liyunlong-fred/motor-vibration-fault-detection/README.md

# 电机振动故障检测

一个以 **STM32 + MPU6050** 为采集端、以 **Python** 为分析与数据管理端的电机/风扇振动检测项目。

项目围绕低速小型直流风扇，建立从传感器采样、频谱分析、串口传输、数据质量检查，到后续**轻量模型**训练与**边缘部署**的完整技术链路。当前模型标签契约聚焦于三类可控工况：**正常、不平衡、安装固定处机械松动**。

项目的核心目标不是只输出一张频谱图，而是把“机械故障机理、嵌入式实时处理、PC 数据管线和可复现实验”连接成一套可以继续扩展的工程骨架。

## 项目亮点

- **端侧实时信号处理**：STM32 以 1 kHz 定时采样，使用 1024 点双缓冲窗口，在板上完成去均值、Hann 窗、CMSIS-DSP 实数 FFT、单边幅值谱和 TOP-5 峰值提取。
- **物理可解释的检测思路**：以转频 1×、2×/3× 谐波、频带能量和幅值变化作为分析线索，优先使用加速度频谱，而不是直接依赖难以解释的原始时域波形。
- **固件与 PC 端同口径对拍**：板上 FFT 和 Python 检查脚本共享采样率、窗口长度、轴向、加窗和峰值搜索范围，可用同一窗口核对 bin、频率和幅值。
- **从原始字节到数据集的完整链路**：固件通过 USART1 发送带窗口序号、采样点数和量程信息的原始数据帧，Python 端负责拆帧、落盘、元数据校验、质量状态管理和 manifest 生成。
- **结构化标签契约**：schema v3 将客观工况、模型标签、标签依据、可信度和机械松动量化字段分开保存，避免把“人为注入条件”和“模型类别”混成一个字符串。
- **面向跨设备验证**：数据集设计保留 `device_id`、`session_id` 等字段，训练清单按设备留出测试集，降低同一台风扇相邻窗口泄漏带来的虚高准确率。
- **问题记录可复用**：传感器异常、软件 IIC 总线冲突、串口 DTR/RTS 复位、频谱选择和故障标签调整均保留了现象、证据、根因和验证方法，方便复盘与二次开发。

## 系统概览

```text
┌──────────────┐   软件 IIC   ┌────────────────────┐
│   MPU6050    │ ── PB6/PB7 ─▶│ STM32F407 应用层   │
└──────────────┘              │ TIM3：1 kHz 采样   │
                              │ 1024 点双缓冲      │
                              └─────────┬──────────┘
                                        │
                         ┌──────────────┴──────────────┐
                         │                             │
                 ┌───────▼────────┐            ┌──────▼───────┐
                 │ 板上 DSP        │            │ USART1       │
                 │ 去均值 + Hann   │            │ 460800 baud  │
                 │ RFFT + TOP-5    │            │ 原始数据帧   │
                 └───────┬────────┘            └──────┬───────┘
                         │                             │
                  文本日志/对拍                 ┌─────▼─────────┐
                                                 │ Python 工具链 │
                                                 │ 解析/检查/归档 │
                                                 │ manifest      │
                                                 └─────┬─────────┘
                                                       │
                                             ┌─────────▼─────────┐
                                             │ 特征/频谱/模型路线 │
                                             │ 训练 → 量化 → 部署 │
                                             └───────────────────┘
```

完整模块边界和数据流见 [系统地图](知识库/20_系统地图.md)；设计背景与范围见 [总体方案与数据流](01_文档/项目规划/02_总体方案与数据流.md) 和 [技术原理与设计边界](01_文档/项目规划/01_技术原理与设计边界.md)。

## 技术路线

### 1. 机械对象与传感器安装

被测对象为低转速小型直流风扇。MPU6050 刚性耦合到风扇外壳或测量夹具，当前数据契约固定 **X 轴为振动测量轴，Y 轴为重力参考轴**。实验通过添加质量模拟不平衡，通过指定安装紧固点的回退圈数或间隙模拟安装固定处机械松动。

硬件平台、接线、电源和传感器安装纪律见 [硬件方案、接线与采购](01_文档/项目规划/03_硬件方案_接线与采购.md)。

### 2. STM32 采样与窗口管理

- 主控方向：STM32F407ZGT6，Cortex-M4F，168 MHz，使用 STM32 HAL、CMSIS 和 CMSIS-DSP。
- 传感器接口：软件 IIC，SCL=`PB6`、SDA=`PB7`，加速度量程为 ±2 g。
- 定时采样：TIM3 产生 1 kHz 采样节拍。
- 缓冲策略：1024 点窗口、双缓冲、采样与处理解耦；窗口完成后携带递增序号交给处理层。
- 数据源：支持真实 MPU6050 数据，也保留合成信号入口用于 DSP 自检。

主要入口位于 [`00_工程文件/APP/app_config.h`](00_工程文件/APP/app_config.h)、[`app_sample.c`](00_工程文件/APP/app_sample.c) 和 [`mpu6050.c`](00_工程文件/Drivers/BSP/MPU6050/mpu6050.c)。

### 3. 板上频谱分析

每个窗口按照下面的顺序处理：

```text
int16 原始加速度
      ↓
量程换算为 g
      ↓
计算均值并去直流
      ↓
乘 Hann 窗
      ↓
CMSIS-DSP arm_rfft_fast_f32
      ↓
单边幅值谱
      ↓
10～400 Hz 搜索 TOP-5 峰值
```

当前参数为 `fs = 1000 Hz`、`N = 1024`，频率分辨率约为 **0.9766 Hz/bin**。板上通过 DWT 周期计数记录 FFT 处理耗时，并以 ASCII 文本日志输出均值、峰值 bin、频率和幅值，便于与 PC 端结果对拍。

DSP 实现见 [`dsp_fft.c`](00_工程文件/APP/dsp_fft.c) 与 [`dsp_fft.h`](00_工程文件/APP/dsp_fft.h)；历史对拍口径见 [D4 板上 FFT 集成与对拍记录](01_文档/技术实施/历史验证/D4_板上FFT集成与对拍记录.md)。

### 4. 串口链路与 PC 解析

USART1 当前配置为 **460800 baud**。一帧原始加速度数据包含帧头、帧类型、轴标识、窗口序号、样本数、量程代码和 little-endian `int16` 样本；1024 点窗口的帧长度为 2057 字节。文本日志使用同一帧头体系，方便串口接收端区分数据帧和日志帧。

固件封装见 [`link_frame.c`](00_工程文件/APP/link_frame.c) / [`link_frame.h`](00_工程文件/APP/link_frame.h)，PC 端对应解析见 [`frames.py`](03_Python工具/py_common/frames.py)。两端的帧格式是通信契约，修改时必须同步验证。

### 5. 数据集与标签契约

Python 侧将数据分成三种使用层次：

1. **debug**：调试串口、传感器和算法，不直接进入训练集；
2. **formal**：按结构化元数据采集、检查并登记的正式原始数据；
3. **processed**：从通过质检的 formal 数据生成的训练/测试清单。

默认工况映射为：

| 客观工况 | 模型标签 | 说明 |
| --- | --- | --- |
| `baseline` | `normal` | 正常运行基线 |
| `added_mass` | `unbalance` | 受控添加质量，模拟转子不平衡 |
| `mount_looseness` | `looseness` | 指定安装点受控松动 |

数据契约、字段解释和历史 schema 兼容规则见 [数据集目录与标签契约](04_数据集/README.md)；操作命令见 [采集操作手册](04_数据集/采集操作手册.md)；唯一配置源见 [`config.json`](03_Python工具/config.json)。

### 6. 特征、训练与边缘部署

完整路线预留两种模型输入：

- **特征路线**：从基频、1×/2×峰值关系、谐波丰富度、频带能量、RMS、峭度等统计量构造小维度特征，训练轻量 MLP 或其他浅模型；
- **频谱路线**：使用 0～400 Hz 的对数幅度谱训练 1D-CNN，在数据量和算力允许时提高表达能力。

两条路线都遵循“按设备划分数据 → PC 端 float32 验证 → int8 量化 → ONNX/TFLite 导出 → X-CUBE-AI 生成 C 网络 → 板上 DWT/Map 文件核对资源”的流程。模型训练与部署设计见 [模型训练与边缘部署](01_文档/项目规划/05_模型训练与边缘部署.md)，显示、报警和交互路线见 [显示、报警与交互](01_文档/项目规划/06_显示报警与交互.md)。

## 技术栈

| 层次 | 技术与用途 |
| --- | --- |
| MCU | STM32F407ZGT6 / Cortex-M4F / 168 MHz |
| 固件语言 | C |
| 外设与底层 | STM32 HAL、CMSIS、TIM、USART、GPIO、DWT |
| 传感器 | MPU6050 加速度计，软件 IIC |
| DSP | CMSIS-DSP `arm_rfft_fast_f32`、Hann 窗、单边幅值谱、峰值与谐波分析 |
| 通信 | USART1，460800 baud，自定义二进制数据帧 + 文本日志帧 |
| PC 工具 | Python、NumPy、Matplotlib、pyserial、结构化 CSV/JSON 元数据 |
| 数据工程 | schema v3、manifest、质量状态、按设备留出测试集 |
| 部署方向 | X-CUBE-AI / int8 量化 / STM32 板上推理 |
| 调试辅助 | USMART、串口日志、DWT 周期计数、板上/PC 对拍 |

## 目录导航

```text
项目根目录/
├── 00_工程文件/       # 当前 STM32 开发工程：APP、Drivers、Middlewares、User
├── 01_文档/            # 项目规划，以及可复用的技术实施与验证文档
├── 02_固件/            # 正式固件归档目录说明
├── 03_Python工具/      # 串口接收、帧解析、频谱检查、谐波分析、数据集工具
├── 04_数据集/          # formal/debug_raw、manifest 与采集/标签契约
├── 05_演示与输出/      # 可复现的频谱图、实验图和报告
├── 06_笔记与踩坑/      # 开发问题和原始实验记录
└── 知识库/              # 当前状态、系统地图、决策索引和问题索引
```

常用入口：

- [项目规划总入口](01_文档/项目规划/README.md)：按主题查看设计文档；
- [技术实施文档](01_文档/技术实施/README.md)：查看硬件操作方法与历史验证记录；
- [系统地图](知识库/20_系统地图.md)：快速定位固件与 PC 模块边界；
- [SYSTEM 基础支持](00_工程文件/Drivers/SYSTEM/README.md)：查看底层延时、系统时钟和 USART 支持的职责与入口；
- [知识库导航](知识库/00_导航.md)：查看当前维护的索引和证据来源；
- [开发问题与解决记录](06_笔记与踩坑/开发问题/README.md)：查看 Q-01～Q-05 的排查过程；
- [演示与输出说明](05_演示与输出/README.md)：了解图表、日志和报告的存放约定。

## 快速使用

在项目根目录打开 PowerShell 后，可以先用下面的命令检查 PC 侧元数据契约、查看采集参数和运行数据集清单工具：

```powershell
python -B 03_Python工具\test_metadata.py
python -B 03_Python工具\recv.py --help
python -B 03_Python工具\make_dataset.py
```

固件参数集中在 [`app_config.h`](00_工程文件/APP/app_config.h)，Python 侧标签与目录参数集中在 [`config.json`](03_Python工具/config.json)。采集真实硬件前，请先阅读 [采集操作手册](04_数据集/采集操作手册.md)，并确认传感器安装、串口号、波特率和工况字段一致。

## 开发中遇到的典型困难

这些问题没有被当作临时备注删除，而是整理成了可复用的排查记录：

| 问题 | 处理思路 | 详细记录 |
| --- | --- | --- |
| 加速度谱还是位移谱 | 对比积分漂移和频率加权影响后，选择更适合本项目频段的加速度谱 | [Q-01：加速度谱与位移谱](06_笔记与踩坑/开发问题/Q-01_加速度谱与位移谱.md) |
| MPU6050 Z 轴异常 | 用 WHO_AM_I、四姿势和自检响应区分软件错误与传感器机械失效，最终固定 X/Y 使用边界 | [Q-02：MPU6050 Z 轴异常](06_笔记与踩坑/开发问题/Q-02_MPU6050_Z轴异常.md) |
| 串口助手有数据而 `recv.py` 无数据 | 排查 USB 串口复位控制线，显式处理 DTR/RTS 状态 | [Q-03：串口助手正常但 recv.py 无数据](06_笔记与踩坑/开发问题/Q-03_recv_py无数据.md) |
| 三轴数据间歇性错乱 | 用总线拓扑和连续读取证据定位 IIC 引脚冲突，改用专属 PB6/PB7 | [Q-04：IIC 三轴整值错乱](06_笔记与踩坑/开发问题/Q-04_IIC三轴整值错乱.md) |
| 第三类故障难以可靠模拟 | 从“标签听起来像故障”转向“可控、可重复、可量化”的安装固定处机械松动 | [Q-05：第三类故障改为机械松动](06_笔记与踩坑/开发问题/Q-05_第三类故障改为机械松动.md) |

## 工程边界与可信度说明

本项目面向低速小型风扇，当前频谱链路重点覆盖约 10～400 Hz 的低阶转频、谐波和结构响应，不覆盖高频冲击型轴承故障。机械松动指风扇与实验底座之间的受控安装异常，不等同于所有工业场景中的松动。任何模型准确率、跨设备泛化能力和板上资源占用，都应以可追溯的数据、日志、混淆矩阵和 map 文件为依据。

如果需要查看工程维护口径，再进入 [当前状态](知识库/10_当前状态.md)；它是状态信息入口，不替代源码、配置、数据和实验记录本身。

## 知识库索引维护

如果修改了带知识库元数据的文档或索引，请在项目根目录运行：

```powershell
python -B 03_Python工具\kb_index.py build
python -B 03_Python工具\kb_index.py check
```
