liyunlong-fred/motor-vibration-fault-detection/01_文档/技术实施/README.md

---
kb_id: TECHNICAL-IMPLEMENTATION-GUIDE
kind: overview
domain: project
lifecycle: current
authority: supporting
last_verified: 2026-09-28
---

# 技术实施文档

本目录存放能够指导后续实现、复现或验证的技术文档；它们不属于项目规划，也不与临时排查笔记混放。

- [硬件验证/风扇测速与机械基频确认](硬件验证/风扇测速与机械基频确认.md)：2 PPR 风扇的 TACH 测速、6 V/12 V 实测结果，以及与振动 FFT 对拍的方法。
- [历史验证/D4 板上 FFT 集成与对拍记录](历史验证/D4_板上FFT集成与对拍记录.md)：2026-09-22 的历史实施和对拍快照，用于追溯，不作为当前待办或当前配置的依据。

当前进度、参数和下一步以[知识库/当前状态](../../知识库/10_当前状态.md)及源码、配置为准。
