liyunlong-fred/motor-vibration-fault-detection/知识库/10_当前状态.md

---
kb_id: PROJECT-CURRENT-STATE
kind: overview
domain: project
lifecycle: current
authority: canonical
last_verified: 2026-09-28
source_paths:
  - 00_工程文件/APP/app_config.h
  - 00_工程文件/APP/app_calibration.h
  - 00_工程文件/User/main.c
  - 00_工程文件/Drivers/BSP/IIC/iic.h
  - 00_工程文件/Drivers/BSP/IIC/iic.c
  - 00_工程文件/Drivers/BSP/MPU6050/mpu6050.c
  - 03_Python工具/config.json
  - 03_Python工具/capture_and_analyze.py
  - 04_数据集/manifest.csv
  - 04_数据集/formal/.gitkeep
  - 04_数据集/采集操作手册.md
  - 06_笔记与踩坑/开发问题/Q-06_1024点窗口采样时序验证.md
  - 06_笔记与踩坑/开发问题/Q-02_MPU6050_Z轴异常.md
  - 06_笔记与踩坑/实验记录/E-01_风扇TACH逻辑分析仪测速.md
  - 05_演示与输出/logic_analyzer/20260928_fan_tach_edge_interval.png
  - requirements.txt
  - .vscode/settings.json
---

# 当前状态

> 本页是项目进度的唯一当前摘要。详细证据仍以链接到的源码、配置、数据和历史记录为准。

## 核实基线

- 核实日期：2026-09-27。
- 本次核实使用的主线基线：`bb64fdf`；本次知识库更新将在该基线上形成新的主线提交。
- 已验证的采样时序测试在远程 `timing-test` 分支完成，使用提交 `4957096` 和 `75ce768`；临时计时打点未合并到主线。
- 固件当前参数：1 kHz 采样、1024 点窗口、真实 MPU6050 数据源、USART1 460800 baud。
- MPU6050：软件 IIC 使用 PB6/PB7，加速度量程为 ±2 g。
- 数据口径：测量轴 X、Y 为静态安装重力参考轴并记录正负号；三类为正常 / 不平衡 / 安装固定处机械松动。schema v4 已在 Python 配置和元数据模块中实现：正式采集强制记录夹具、传感器、测点、安装姿态、标定与固件构建；文件头仅保存不可变采集事实，质检、划分和文件 SHA-256 以 manifest 为准。轴承异常已退出项目范围。
- Python 环境：项目根目录 `.conda/` 已统一为 Python 3.13.13；依赖版本记录在根目录 `requirements.txt`，VS Code 默认解释器指向 `${workspaceFolder}\\.conda\\python.exe`。

## 已完成并有证据

- STM32 定时采样、1024 点双缓冲、串口数据帧和文本日志帧已实现。
- 板上完成去均值、Hann 窗、CMSIS-DSP 实数 FFT 和 10～400 Hz TOP-5 峰值输出。
- 历史对拍中，同一窗口的板上与 PC 端 bin、频率和幅值一致；操作与验证口径见 [D4 板上 FFT 集成与对拍记录](../01_文档/技术实施/历史验证/D4_板上FFT集成与对拍记录.md)，原始输出保存在 `05_演示与输出/boardlog/`。
- Python 侧已有接收、频谱、峰值、谐波、原始数据检查和数据集清单工具。
- Python 侧已有 `capture_and_analyze.py` 统一入口：可选择 debug/formal/selftest/calibration，填写标签后调用现有接收器完成采集，并仅针对本次 CSV 自动显示完整性、频谱、逐窗稳定性、峰值和谐波结果；formal 仍须由操作者确认现场事实后更新 manifest 质检状态。
- 2026-09-28：采集窗口已预填当前固定工装的模块/测点/姿态（`mpu01` / `fan_frame_top_left` / `x_measure_y_gravity`），并提供“强制结束本次采集”。强制结束会在当前串口读超时后释放串口且不保存部分数据；窗口关闭同样会先请求停止。
- 2026-09-28：MPU6050 软件 IIC 的 PB6/PB7 均已改为开漏，启动时会执行 9 个 SCL 脉冲的总线恢复；初始化日志会记录重试次数、总线恢复码、失败阶段和 `WHO_AM_I`，并每秒重试而非进入无日志死循环。尚待重新编译、烧录和上板验证。
- schema v4 标签契约、松动量化字段、采集溯源、元数据读写和数据集清单生成代码已落地；`make_dataset.py` 会拒绝文件 SHA-256 与 manifest 不一致的记录。`test_metadata.py` 覆盖默认映射、缺失量化值拦截、完整松动记录、元数据往返、不可变文件头和 manifest 写入；`test_make_dataset.py` 覆盖完整性门禁。
- 面向非开发人员的数据采集操作手册已建立，覆盖 PowerShell 环境准备、debug/formal 切换、各类工况命令、采集后检查和训练集划分。
- 2026-09-26 完成 1024 点窗口采样时序验证：窗口内 `span=1023`、`miss=0`、`readfail=0`，6 帧串口接收 `lost_frames=0`；但窗口之间仍有约 51～52 ms 暂停，详见 [Q-06 采样时序验证](../06_笔记与踩坑/开发问题/Q-06_1024点窗口采样时序验证.md)。
- 2026-09-26 已在目标板完成连续采样版本验收：真实 MPU6050、1 kHz、1024 点窗口、460800 baud 条件下连续接收 600 帧（614400 样本）；帧序号为 1～600，`first_sample_id` 连续，PC 端 `lost_frames=0`、`sample_id_gaps=0`。全程板端统计 `break`、`fifo_ovf`、`iic_fail`、`win_drop`、`tx_drop`、`tx_err` 均为 0，详见 [Q-06 采样时序验证](../06_笔记与踩坑/开发问题/Q-06_1024点窗口采样时序验证.md)。
- 2026-09-27 已完成当前接入模块的六面静态标定记录：X/Y/Z 的零偏分别为 802.83 / 38.67 / 220.50 count，灵敏度分别为 16483.17 / 16435.00 / 16844.17 count/g；六组回代模长为 1.00000～1.00017 g。完整原始日志、姿态归类和适用边界见 [Q-02 MPU6050 Z 轴异常](../06_笔记与踩坑/开发问题/Q-02_MPU6050_Z轴异常.md)。
- 2026-09-28 已用逻辑分析仪完成风扇 TACH 独立测速，并确认 TACH 为 2 脉冲/转：6 V 平均周期约 9.8 ms，对应机械 1× 约 51.02 Hz、3061 RPM；12 V 平均周期约 5.45 ms，对应机械 1× 约 91.74 Hz、5505 RPM。另有一张周期 6.881083 ms 的截图，对应机械 1× 72.663 Hz、4360 RPM，但该截图供电电压尚未标注。详见 [E-01 风扇 TACH 逻辑分析仪测速](../06_笔记与踩坑/实验记录/E-01_风扇TACH逻辑分析仪测速.md)。
- 2026-09-28 已修正 Python 谐波工具的机械 1×规则：默认仅在 45～105 Hz 的已验证范围内从实际谱峰选择候选，约 36.6 Hz 的低频分量不再参与基频选择；CSV 有同工况 `rpm_measured` 时，机械 1×固定为 `RPM/60` 并以频谱核对。旧的“铭牌转速按供电电压线性外推”规则已移除。

## 尚未完成

- `04_数据集/manifest.csv` 只有表头，`formal/` 只有 `.gitkeep`：当前正式样本数为 0。
- 6 V、12 V TACH 已形成实测记录，但 9 V 尚未按同一格式补测，且现有振动数据没有与 TACH 同步关联。截图工况在 PPR=2 下的机械 1× 为 72.663 Hz；只有确认截图电压和对应振动数据后，才能把既有 73.2 Hz 峰正式闭环为 1×。
- 已完成六面静态标定记录，但补偿系数尚未接入采样、FFT 或 Python 换算；当前正式测量仍是未校准的 X 轴原始数据。
- 2026-09-27：`APP_CALIBRATION_MEAN_LOG` 已在目标板用于六面静态标定。该开关默认关闭；设为 `1` 时，固件每个 1024 点窗口经文本帧输出 `CAL_MEAN` 的 X/Y/Z 原始计数均值。
- 历史 `timing-test` 的旧版 boardlog 与现行连续采样固件并非同一版本；旧证据只能用于说明改造前的窗口边界暂停，不能替代本版本的验收结果。
- MPU6050 IIC 修复尚未在目标板重新编译、烧录和复现上电初始化；不能据此宣称间歇性初始化失败已完成硬件验收。

## 下一步

1. 按 [风扇测速与机械基频确认](../01_文档/技术实施/硬件验证/风扇测速与机械基频确认.md) 补测带电压标签的 9 V TACH，并同步采集 6 V、9 V、12 V 振动谱；使用实测机械 1×（6 V 为 51.02 Hz、12 V 为 91.74 Hz）验证谱线跟踪关系。
2. 固定模块编号与安装姿态，独立复测六面标定并决定是否把补偿系数接入链路；随后完成正式采集流程验证，再向 `formal/` 写入样本并登记 manifest。
3. 搭建刚性底板夹具，先用同一风扇验证 `M1` 回退 1/4 圈、1/2 圈的机械松动是否可重复且不会造成整机位移。
4. 正式样本质检通过后，才开始特征提取和模型训练。

## 当前主要风险

- 现有历史频谱没有与本次 TACH 记录同步采集；在电压标签和同工况对拍完成前，不能继续沿用“36.6 Hz 是 1×、73.2 Hz 是 2×”的旧解释。截图工况若与该频谱相同，则 PPR=2 会指向相反结论：73.2 Hz 附近更可能是 1×。
- 七叶片 BPF 在截图工况和 12 V 工况分别约 508.64 Hz、642.20 Hz，超过 1 kHz 采样的 500 Hz 奈奎斯特频率，存在前端衰减或混叠风险，不能直接用带内峰反推叶频。
- 机械松动尚无重复性数据；若夹具、紧固点或回退圈数记录不一致，模型可能只学到台面耦合差异。
- 历史 `HANDOFF.md` 当前不在工作树中；若后续恢复，只能作为 2026-09-22 快照，不得替代本页当前状态。
- 规划文档中少量目录名、指标表述和当前实现仍可能不一致，不能直接当运行事实。
