liyunlong-fred/motor-vibration-fault-detection/知识库/20_系统地图.md

---
kb_id: SYSTEM-MAP
kind: overview
domain: firmware
lifecycle: current
authority: supporting
last_verified: 2026-09-28
source_paths:
  - 00_工程文件/APP/app_config.h
  - 00_工程文件/APP/app_calibration.h
  - 00_工程文件/APP/app_sample.c
  - 00_工程文件/APP/dsp_fft.c
  - 00_工程文件/APP/link_frame.c
  - 00_工程文件/Drivers/SYSTEM/README.md
  - 03_Python工具/recv.py
  - 03_Python工具/py_common/frames.py
  - 03_Python工具/py_common/metadata.py
  - 06_笔记与踩坑/实验记录/E-01_风扇TACH逻辑分析仪测速.md
---

# 系统地图

## 数据流

```text
MPU6050
  │ 传感器内部 FIFO：1 kHz、仅三轴加速度（6 B/样本）
  ▼
app_sample.c
  │ TIM3 服务提示、FIFO 批量取样、三槽连续窗口队列，X 为测量轴
  ├──────────────► （可选）CAL_MEAN 文本帧：每窗口 X/Y/Z 原始计数均值
  ├──────────────► link_frame.c ── USART1 TX DMA 队列 ──► recv.py
  │                                                   ├─ debug_raw / raw
  ▼                                                   └─ formal + manifest.csv
dsp_fft.c
  │ 去均值 + Hann + 1024 点 RFFT
  └─ 10～400 Hz TOP-5 ── 文本日志帧 ────────────────► boardlog
```

## 独立转速验证链

```text
风扇 TACH（2 脉冲/转）
  │ 3.3 V 上拉、相邻下降沿周期
  ▼
逻辑分析仪
  │ f_tach = 1/T，机械 1× = f_tach/2，RPM = f_tach×30
  ▼
E-01 测速记录 ──► 与同电压振动 FFT 对拍
```

该链路独立于 STM32 固件，当前用于验证机械基频，不进入串口数据帧。已实测 6 V 机械 1× 约 51.02 Hz、12 V 机械 1× 约 91.74 Hz；9 V 和同步振动对拍尚待完成。

## 固件边界

| 模块 | 责任 | 主要入口 |
|---|---|---|
| `app_config.h` | 采样率、窗口、数据源、串口等统一参数 | `APP_FS_HZ`、`APP_FRAME_N`、`APP_UART_BAUD` |
| `app_sample.c` | TIM3 服务提示、FIFO/桩数据、三槽连续窗口管理与连续性统计 | `app_sample_init/task/get/release/stats_get` |
| `dsp_fft.c` | 窗函数、RFFT、单边幅值和找峰 | `dsp_fft_init/run/print/selftest` |
| `link_frame.c` | 数据帧和文本日志帧封装；加速度帧携带 `first_sample_id` | `link_frame_send`、`link_text_send` |
| [`Drivers/SYSTEM/`](../00_工程文件/Drivers/SYSTEM/README.md) | 时钟、延时与 USART DMA 队列支持 | `delay/`、`sys/`、`usart/` |
| `main.c` | 初始化和主循环调度 | `main` |
| `iic.c`、`mpu6050.c` | 软件 IIC、传感器寄存器与加速度 FIFO 批量读取；PB6/PB7 均开漏，启动前总线恢复 | `iic_init/iic_bus_recover`、`mpu6050_init/fifo_read_raw` |

## PC 工具边界

| 模块 | 责任 |
|---|---|
| `recv.py` | 串口接收、DTR/RTS 处理、数据和日志落盘 |
| `capture_and_analyze.py` | 交互式采集编排：预填当前固定工装溯源、调用 `recv.py` 并对本次 CSV 自动执行完整性、频谱、峰值和谐波汇总；可强制结束并释放串口，取消时不保存部分数据；仅在人工确认后更新 formal 的 manifest 质检状态 |
| `py_common/frames.py` | 与固件一致的帧解析 |
| `py_common/metadata.py` | schema v4 元数据、机械松动量化与采集溯源校验、不可变 CSV 头和 manifest |
| `plot_check.py` / `peak_check.py` | 波形频谱和板上/PC 对拍 |
| `harmonics.py` | 机械 1×、转速和谐波族分析；默认只在已验证的 45～105 Hz 范围内选实际谱峰，CSV 的同工况 `rpm_measured` 会以 `RPM/60` 锁定机械 1× |
| `make_dataset.py` | 从通过质检且文件 SHA-256 与 manifest 一致的 formal 样本生成训练清单 |

## 权威来源

- 参数值：`app_config.h`、`mpu6050.h`、`config.json`。
- 帧格式：`link_frame.h` 与 `py_common/frames.py`，修改时必须同步。
- 数据标签：`04_数据集/README.md`、`config.json`、`metadata.py`；当前三类为 `normal / unbalance / looseness`。
- 当前进度：[当前状态](10_当前状态.md)。
