liyunlong-fred/motor-vibration-fault-detection/知识库/40_问题与实验索引.md

---
kb_id: ISSUE-EXPERIMENT-INDEX
kind: troubleshooting
domain: project
lifecycle: current
authority: supporting
last_verified: 2026-09-28
---

# 问题与实验索引

## 已记录问题

| 编号 | 主题 | 状态 | 结论入口 |
|---|---|---|---|
| Q-01 | 加速度谱与位移谱选择 | 待后续模型实测补充 | [Q-01](../06_笔记与踩坑/开发问题/Q-01_加速度谱与位移谱.md) |
| Q-02 | MPU6050 Z 轴历史机械异常与当前模块六面复测 | 当前模块六面静态响应正常；模块身份与独立复测待补 | [Q-02](../06_笔记与踩坑/开发问题/Q-02_MPU6050_Z轴异常.md) |
| Q-03 | 串口助手正常但 recv.py 无数据 | 已解决：显式处理 DTR/RTS | [Q-03](../06_笔记与踩坑/开发问题/Q-03_recv_py无数据.md) |
| Q-04 | 三轴读数间歇性整值错乱 | 已解决：IIC 改至 PB6/PB7 | [Q-04](../06_笔记与踩坑/开发问题/Q-04_IIC三轴整值错乱.md) |
| Q-05 | 第三类故障是否采用轴承磨损 | 已决策：改为安装固定处机械松动，不保留轴承异常扩展 | [Q-05](../06_笔记与踩坑/开发问题/Q-05_第三类故障改为机械松动.md) |
| Q-06 | 1024 点窗口采样时序与漏采 | 改造前窗间暂停 51～52 ms；连续采样源码已改造，待上板复测 | [Q-06](../06_笔记与踩坑/开发问题/Q-06_1024点窗口采样时序验证.md) |

## 已有验证

- 板上 FFT 桩信号自检曾通过；详见 [D4 历史验证记录](../01_文档/技术实施/历史验证/D4_板上FFT集成与对拍记录.md)。
- 板上与 PC 对同一窗口的峰值结果曾完全一致；验证方法见 [D4 板上 FFT 集成与对拍记录](../01_文档/技术实施/历史验证/D4_板上FFT集成与对拍记录.md)，原始输出见 `05_演示与输出/boardlog/`。
- schema v4 元数据模块配有本地自检 `test_metadata.py`。
- 2026-09-24 已运行元数据、谐波和知识库测试，均通过；这只证明软件契约与既有算法未回归，不代表机械松动已经实测可分。
- 2026-09-26 已完成 1024 点窗口采样时序验证；窗口内 `span=1023`、`miss=0`、`readfail=0`，但窗口间仍有约 51～52 ms 暂停；详见 [Q-06](../06_笔记与踩坑/开发问题/Q-06_1024点窗口采样时序验证.md)。
- 2026-09-28 已用逻辑分析仪完成风扇 TACH 独立测速并确认 2 脉冲/转：6 V 平均周期 9.8 ms，对应 51.02 Hz / 3061 RPM；12 V 平均周期 5.45 ms，对应 91.74 Hz / 5505 RPM。周期 6.881083 ms 的截图对应 72.663 Hz / 4360 RPM，但电压标签尚待补充；详见 [E-01](../06_笔记与踩坑/实验记录/E-01_风扇TACH逻辑分析仪测速.md)。

## 待完成实验

- 补测并明确标注 9 V TACH，记录周期数、总时间、平均/最小/最大周期；随后同步采集 6 V、9 V、12 V 振动谱，完成 TACH 机械 1× 与 FFT 谱线对拍。执行入口见 [风扇测速与机械基频确认](../01_文档/技术实施/硬件验证/风扇测速与机械基频确认.md)。
- 重新烧录当前源码并生成新的板上/PC 对拍记录。
- 固定模块编号与安装姿态后，独立复测传感器六面标定；决定是否将已记录的量程/零偏补偿接入数据链路。
- 多设备、多电压、三类别的正式数据采集与质检。
- 指定紧固点在基准、回退 1/4 圈、回退 1/2 圈之间的重复装拆实验，验证机械松动特征可重复且整机不位移。
- 加速度特征与可选速度 RMS 的分类效果对照。
