liyunlong-fred/motor-vibration-fault-detection/知识库/索引/文档与模块索引.md

# 文档与模块索引

> 由 `python -B 03_Python工具/kb_index.py build` 生成，请勿手工编辑。

## 受管文档

| 文档 | 类型 | 领域 | 生命周期 | 权威级别 | 最后核实 |
|---|---|---|---|---|---|
| [项目文档](<../../01_文档/README.md>) | overview | project | current | supporting | 2026-09-25 |
| [外设信息与参考资料](<../../01_文档/外设信息/README.md>) | reference | hardware | current | reference | 2026-09-25 |
| [技术实施文档](<../../01_文档/技术实施/README.md>) | overview | project | current | supporting | 2026-09-28 |
| [D4 板上 FFT 集成与对拍记录（CMSIS-DSP 1024 点实数 FFT + Hann 窗）](<../../01_文档/技术实施/历史验证/D4_板上FFT集成与对拍记录.md>) | procedure | dsp | snapshot | supporting | 2026-09-22 |
| [风扇测速与机械基频确认](<../../01_文档/技术实施/硬件验证/风扇测速与机械基频确认.md>) | procedure | hardware | current | supporting | 2026-09-28 |
| [项目章程与验收](<../../01_文档/项目规划/00_项目章程与验收.md>) | design | project | current | supporting | 2026-09-24 |
| [技术原理与设计边界](<../../01_文档/项目规划/01_技术原理与设计边界.md>) | design | dsp | current | supporting | 2026-09-24 |
| [总体方案与数据流](<../../01_文档/项目规划/02_总体方案与数据流.md>) | design | firmware | current | supporting | 2026-09-24 |
| [硬件方案、接线与采购](<../../01_文档/项目规划/03_硬件方案_接线与采购.md>) | design | hardware | current | supporting | 2026-09-24 |
| [固件与 PC 软件架构](<../../01_文档/项目规划/04_固件与PC软件架构.md>) | design | firmware | current | supporting | 2026-09-24 |
| [模型训练与边缘部署](<../../01_文档/项目规划/05_模型训练与边缘部署.md>) | design | ml | current | supporting | 2026-09-24 |
| [显示、报警与交互](<../../01_文档/项目规划/06_显示报警与交互.md>) | design | firmware | current | supporting | 2026-09-24 |
| [里程碑与路线图](<../../01_文档/项目规划/07_里程碑与路线图.md>) | design | project | current | supporting | 2026-09-24 |
| [简历答辩与学习路线](<../../01_文档/项目规划/08_简历答辩与学习路线.md>) | reference | project | current | supporting | 2026-09-24 |
| [风险、扩展与参考资料](<../../01_文档/项目规划/09_风险扩展与参考资料.md>) | reference | project | current | supporting | 2026-09-24 |
| [项目决策登记](<../../01_文档/项目规划/10_项目决策登记.md>) | decision | project | current | supporting | 2026-09-24 |
| [调试组件：USMART](<../../01_文档/项目规划/11_调试组件_USMART.md>) | reference | firmware | current | supporting | 2026-09-24 |
| [项目规划](<../../01_文档/项目规划/README.md>) | overview | project | current | canonical | 2026-09-24 |
| [正式原始数据（formal）](<../../04_数据集/formal/README.md>) | reference | data | current | canonical | 2026-09-25 |
| [数据集目录与标签契约](<../../04_数据集/README.md>) | reference | data | current | canonical | 2026-09-24 |
| [数据集设计与采集计划](<../../04_数据集/数据集设计与采集计划.md>) | design | data | current | supporting | 2026-09-24 |
| [电机振动故障检测：统一采集窗口操作手册](<../../04_数据集/采集操作手册.md>) | procedure | data | current | supporting | 2026-09-28 |
| [演示与输出](<../../05_演示与输出/README.md>) | reference | tooling | current | supporting | 2026-09-28 |
| [笔记与踩坑](<../../06_笔记与踩坑/README.md>) | overview | project | current | canonical | 2026-09-28 |
| [E-01：风扇 TACH 逻辑分析仪测速](<../../06_笔记与踩坑/实验记录/E-01_风扇TACH逻辑分析仪测速.md>) | experiment | hardware | current | supporting | 2026-09-28 |
| [加速度谱与位移谱](<../../06_笔记与踩坑/开发问题/Q-01_加速度谱与位移谱.md>) | troubleshooting | dsp | current | supporting | 2026-09-24 |
| [MPU6050 Z 轴异常](<../../06_笔记与踩坑/开发问题/Q-02_MPU6050_Z轴异常.md>) | troubleshooting | hardware | current | supporting | 2026-09-27 |
| [串口助手正常但 recv.py 无数据](<../../06_笔记与踩坑/开发问题/Q-03_recv_py无数据.md>) | troubleshooting | tooling | current | supporting | 2026-09-24 |
| [IIC 三轴整值错乱](<../../06_笔记与踩坑/开发问题/Q-04_IIC三轴整值错乱.md>) | troubleshooting | hardware | current | supporting | 2026-09-24 |
| [第三类故障改为机械松动](<../../06_笔记与踩坑/开发问题/Q-05_第三类故障改为机械松动.md>) | troubleshooting | data | current | supporting | 2026-09-24 |
| [Q-06：1024 点窗口采样时序与漏采验证](<../../06_笔记与踩坑/开发问题/Q-06_1024点窗口采样时序验证.md>) | troubleshooting | firmware | current | supporting | 2026-09-26 |
| [开发问题与解决记录](<../../06_笔记与踩坑/开发问题/README.md>) | troubleshooting | project | current | supporting | 2026-09-24 |
| [电机振动故障检测](<../../README.md>) |  |  |  |  |  |
| [项目知识库导航](<../00_导航.md>) | overview | project | current | supporting | 2026-09-28 |
| [当前状态](<../10_当前状态.md>) | overview | project | current | canonical | 2026-09-28 |
| [系统地图](<../20_系统地图.md>) | overview | firmware | current | supporting | 2026-09-28 |
| [决策索引](<../30_决策索引.md>) | decision | project | current | supporting | 2026-09-28 |
| [问题与实验索引](<../40_问题与实验索引.md>) | troubleshooting | project | current | supporting | 2026-09-28 |
| [项目知识库](<../README.md>) | overview | project | current | supporting | 2026-09-27 |

## 关键模块

| 模块 | 领域 | 责任 |
|---|---|---|
| [数据元数据契约](<../../03_Python工具/py_common/metadata.py>) | data | schema v4 校验、机械松动量化与采集溯源字段、不可变 CSV 头和 manifest |
| [标签与路径配置](<../../03_Python工具/config.json>) | data | 受控枚举、轴向与数据目录 |
| [训练清单生成](<../../03_Python工具/make_dataset.py>) | data | 筛选通过质检且文件完整性匹配的正式样本 |
| [板上 FFT](<../../00_工程文件/APP/dsp_fft.c>) | dsp | 去均值、Hann、RFFT、单边幅值和 TOP-5 |
| [SYSTEM 基础支持](<../../00_工程文件/Drivers/SYSTEM/README.md>) | firmware | 延时、系统时钟与 USART 底层支持的职责说明和子目录入口 |
| [上行帧协议](<../../00_工程文件/APP/link_frame.h>) | firmware | 数据帧与日志帧协议定义 |
| [固件入口](<../../00_工程文件/User/main.c>) | firmware | 外设初始化与主循环调度 |
| [固件统一参数](<../../00_工程文件/APP/app_config.h>) | firmware | 采样率、窗口长度、数据源与串口波特率 |
| [采样与窗口管理](<../../00_工程文件/APP/app_sample.c>) | firmware | TIM3 心跳、MPU6050 采样与双缓冲 |
| [MPU6050 配置](<../../00_工程文件/Drivers/BSP/MPU6050/mpu6050.h>) | hardware | 量程、寄存器和灵敏度定义 |
| [软件 IIC 引脚定义](<../../00_工程文件/Drivers/BSP/IIC/iic.h>) | hardware | PB6/PB7 接线和 GPIO 宏 |
| [PC 帧解析](<../../03_Python工具/py_common/frames.py>) | tooling | 与固件帧协议对拍 |
| [串口采集入口](<../../03_Python工具/recv.py>) | tooling | 接收、分帧、元数据采集与落盘 |

## 重要附件

| 附件 | 领域 | 用途 | 分发策略 |
|---|---|---|---|
| [9 V 加质量样本频谱](<../../05_演示与输出/20260922_175755_fan9v_unbalance_X_f0001-0020_spectrum.png>) | dsp | 2× 分量增强的频谱证据 | project |
| [9 V 正常样本频谱](<../../05_演示与输出/20260922_175513_fan9v_normal_X_f0001-0020_spectrum.png>) | dsp | 正常状态频谱里程碑图 | project |
| [MPU-6000/6050 Product Specification](<../../01_文档/外设信息/GY521mpu-6050资料/PS-MPU-6000A.pdf>) | hardware | 本地芯片电气与性能参考资料 | local-reference |
| [MPU-6000/6050 Register Map](<../../01_文档/外设信息/GY521mpu-6050资料/RM-MPU-6000A.pdf>) | hardware | 本地芯片寄存器参考资料 | local-reference |
| [MPU6050 寄存器选用表](<../../01_文档/外设信息/MPU6050寄存器选用表_电机振动检测.xlsx>) | hardware | 项目使用寄存器、位域和配置值速查 | project |
| [风扇 TACH 相邻下降沿间隔](<../../05_演示与输出/logic_analyzer/20260928_fan_tach_edge_interval.png>) | hardware | 逻辑分析仪测得 6.881083 ms 周期与约 50% 占空比的原始截图 | project |
