liyunlong-fred/motor-vibration-fault-detection/01_文档/项目规划/03_硬件方案_接线与采购.md

---
kb_id: PROJECT-HARDWARE
kind: design
domain: hardware
lifecycle: current
authority: supporting
last_verified: 2026-09-24
migration_source: C:/Work/备份/电机振动故障检测/_Obsidian迁移前/_20260924/电机振动故障检测_项目规划.md
---

# 硬件方案、接线与采购

## 1. 当前硬件口径

MPU6050 使用软件 IIC，SCL=PB6、SDA=PB7；不使用硬件 I2C1、DMA 或原文 PB8/PB9 共用总线方案。数据契约为 X 测量轴、Y 重力轴。六面标定、刚性底板和 M1 往返松动验证尚未完成；采购价格和持有状态均只作参考。

## 2. 器件与安装

### 2.1 主控平台

| 方案 | 内核 | 主频 | 资源 | 参考价 | 结论 |
| --- | --- | --- | --- | --- | --- |
| 已有 STM32F103ZE（战舰/精英类板） | Cortex-M3 | 72 MHz | 512K F/64K R，无 FPU | 已有 | 保留作学习过渡；无 FPU/DSP，做 AI 推理偏吃力，**不作为最终交付平台** |
| **正点原子 探索者 STM32F407ZGT6（推荐购入）** | **Cortex-M4F** | **168 MHz** | **1 MB F / 192 KB R（128+64），硬件 FPU+DSP** | **约 ¥200–400（以官方店套餐为准）** | ✅ **最终平台**：性能足够跑量化模型；正点原子视频/教程/Keil 例程生态与你所学完全一致；板载蜂鸣器/LED/按键/USB 串口可复用；X-CUBE-AI 官方支持 |
| 阿波罗 STM32F429 | Cortex-M4F | 180 MHz | 2 MB/256 KB | 更高 | 🟡 更强但价格高，本题用不上（除非想玩大屏/LTDC） |
| 阿波罗 STM32H750/H743 | Cortex-M7 | 480 MHz | 大 | 更高 | 🟡 性能过剩、功耗与上手成本高，面试也难解释"为什么需要" |

**选购与上手提示**：

- **已定：购买含 4.3″ 彩色触摸屏的套餐**（你已询到约 ¥250，具体型号以套餐为准）——显示直接做在这块屏上（大字号状态 + 实时频谱），**不再购买 OLED**；屏幕驱动直接用官方《LCD 显示例程》（含触摸初始化），我们只在其上画 UI，无需从零驱动；到手先跑官方 LCD 例程确认屏幕点亮；
- **调试器：已有 DAP（CMSIS-DAP）即可用**——探索者板板载的是 USB 转串口（CH340，只能通信不能下载），下载/单步调试走 SWD 四线（SWDIO/SWCLK/GND/3V3，可选 RST）：Keil5 的 Debug 设置选 **CMSIS-DAP Debugger**；解锁/读保护等操作用 **STM32CubeProgrammer**（同样支持 CMSIS-DAP）。**无需另购 ST-Link**；
- **到货前不要干等**：先完成 Day 1 的 Python 速成 + 从正点原子官网下载《探索者 STM32F407 开发指南》与 HAL 例程、CubeMX 工程模板，跑通"点灯+串口 printf"的例程结构；
- 简历口径统一写最终平台 F407，F103 板只作为早期学习经历。

### 2.2 传感器与物料

| # | 物料 | 规格/理由 | 参考价 | 备注 |
| --- | --- | --- | --- | --- |
| 1 | MPU6050 模块（GY-521） | 六轴，本项目只用加速度计；模块自带 I2C 上拉与稳压  | ¥5–15 | 建议直接 3.3 V 供电避免电平问题；若用正点原子官方 MPU6050 模块则按官方例程接 |
| 2 | 蜂鸣器 | 优先复用**探索者板载 BEEP**（例程有宏） | ¥0 | 无板载或想外接再买模块（¥1–3） |
| 3 | 继电器模块（5V，光耦隔离，如 SRD-05VDC） | 演示联动断负载 | ¥3–8 | 只接低压负载演示；别用继电器去切 220 V 实验 |
| 4 | **12 V 直流小风扇（已购：6 cm，12 V，0.21–0.5 A，2300–3500 rpm，小 4pin 口）** | **可控实验台**：受控注入不平衡和安装固定处机械松动 | ¥10–30/台 | 当前有两台风扇；风扇 B 完全留出测试。电源为 DC 12V 2A 可调，小 4pin 一拖五；一次只运行一台风扇。 |
| 5 | 刚性底板、M4 螺栓/平垫/防松螺母、C 形夹 | 固定两台 12 V 风扇并受控注入安装松动 | 约 ¥20–50 | 利用风扇原安装孔；紧固点编号 M1、M2……；底板夹紧桌面，松动实验只改变一个安装紧固点 |
| 6 | 下载调试器（DAP-Link / CMSIS-DAP） | 下载+调试探索者板（SWD） | 已有，¥0 | 你已有 DAP：Keil5 选 CMSIS-DAP 调试器即可，无需另购 ST-Link |
| 7 | 面包板/洞洞板、杜邦线若干 | 搭电路 | ¥10–20 | |
| 8 | USB-TTL 模块 | 备选（探索者板载 CH340 即可，一般不用另买） | ¥0–10 | 数据量大时可调高波特率（921600） |
| 9 | （演示负载）12 V LED 灯带/灯珠 | 报警联动演示的负载 | ¥5–10 | 继电器断开它，视频里看得清 |
| 10  | （可选）逻辑分析仪（8 通道） | 抓 I2C/串口/时序，调试神器 | ¥25–40 | 强烈建议配一个 |
| 11  | （可选）万用表 | 供电/短路排查 | 已有 | |
| 合计  | 开发板之外 | | **约 ¥50–140**（不含逻辑分析仪则更低） | 另加探索者板**含屏套餐约 ¥250**（用户询价）；整机约 ¥300–400，≤ ¥500 已确认 |

### 2.3 传感器安装

- MPU6050 必须与电机/风扇外壳**刚性耦合**：双面胶/手持会严重衰减中高频并引入共振。**重要**：传感器**不永久固定在某台风扇上**——本项目一次只测 1 台，把传感器装在**可移动的"测量夹具"**上，测完一台换下一台；**买 2 个够用（1 主 1 备），不必每台风扇配 1 个**；
- **非永久固定方式（推荐优先）**：①**螺丝拧紧**（推荐）：用 M2/M3 小螺丝把传感器固定在一块铝 L 角码/固定片上，角码再用扎带或自攻小螺丝固定到风扇塑料框（避开叶片、不破坏平衡），换风扇即拆即移；②**G 型夹 / 小台钳夹具**：夹在风扇框上、夹口垫硅胶，一个夹具依次夹每台，最省事也最公平；③**3M VHB 强力双面胶**：粘牢但可撬下移位（对 0–400 Hz 频段衰减可接受）；④**蜡 / 热熔胶**：非真永久，加热或异丙醇可揭，但麻烦。**固定方式不影响功能，重点是"刚性 + 可复现"**；
- **贴装方向**：排针让商家焊成"向上"——模块底面平整贴安装面、杜邦线从上方插（若排针向下，则元件面朝下贴、针脚朝上接线也可用，别让胶盖住芯片丝印以对轴）；
- **轴向约定**：当前数据契约固定为 X 轴振动测量、Y 轴重力参考。传感器安装后须先检查轴向；不得把历史桩信号的 Y 轴约定当作当前采集轴。
- **测量纪律**：所有样本保持同一夹具、同一安装点（靠近轴承/电机壳中心、径向）和同一手法。相对特征可容忍少量差异，但位置一致性仍是复现性的前提；
- 测量方向对准**径向**（垂直转轴），固定点尽量靠近轴承座/电机壳体中心；
- 实验过程保持传感器与线缆不晃动，避免引入伪振动；
- 记录安装方式照片放进 GitHub README（重现性）。

---

## 3. 硬件接线

### 3.1 接线说明

| 功能 | 器件引脚 | STM32 引脚（示例） | 说明 |
| --- | --- | --- | --- |
| IIC 时钟（软件模拟） | MPU6050 SCL | **PB6** | 不使用硬件 I2C1；由 GPIO 位操作产生，保持 delay_us(2)。 |
| IIC 数据（软件模拟） | MPU6050 SDA | **PB7** | 使用专属引脚，不与板载 24C02 共用总线；传感器以 3.3 V 供电。 |
| 电源 3.3 V / 地 | VCC / GND | 3V3 / GND | 传感器用 3.3 V，可靠共地（4.3″ 屏走板载 LCD 接口，不需单独供电/接线） |
| 蜂鸣器 | 板载 BEEP | 以《探索者开发指南》例程宏为准 | **优先复用板载**，少接一个模块 |
| 继电器（演示用） | 继电器模块 IN | 任一**确认空闲**的 GPIO（如 PA5/PB1，先对照原理图避开被 LCD/模块接口占用的脚） | 模块自带光耦驱动；负载走 5 V/12 V 演示回路，勿直连 220 V |
| 按键 | 板载 KEY（KEY0/WK_UP 等） | 以例程为准 | 预留给报警复位或页面切换（EXTI） |
| LED | 板载 DS0/DS1 | 以例程为准 | 运行/状态指示 |
| 4.3″ 触摸屏 | 板载 LCD 接口 | 官方例程已配置（以《开发指南》为准） | 本项目 UI 直接画在这块屏上；驱动/触摸复用官方 LCD 例程，无需自己从零驱动 |
| 调试/数据口 | 板载 CH340 → PC | USART1（PA9/PA10） | 日志与数据上送；当前配置为 460800 baud。 |
| 12 V 直流风扇 | 独立电源/调速器 | 与逻辑共 GND | 用可调电源或降压模块调速，多档采集 |

**要点**：

- 探索者板外设（LCD、模块接口等）占用大量引脚，CubeMX 里**引脚冲突会标红**，接线前先查《探索者开发指南》原理图；
- 通电前：万用表量 3.3 V/5 V 对地无短路；I2C 两线别插反；先跑通官方例程点亮 4.3″ 屏 + 读通 MPU6050，再接蜂鸣器/继电器；
- 演示级报警在调试阶段可先用**板载 LED 闪烁 + 板载蜂鸣器**代替继电器，减少接线出错面。

---

## 4. 采购清单

> 平台建议：淘宝 / 京东；价格为市场参考价（¥），以实际为准。总预算：**整机 ≤ ¥500（含开发板）**。

### 4.1 必买项

| # | 物品 | 搜索关键词 | 数量 | 参考价 | 用途与要点 |
| --- | --- | --- | --- | --- | --- |
| 1 | **正点原子探索者开发板（含 4.3″ 触摸屏）** | 正点原子 探索者 STM32F407ZGT6 开发板 4.3寸屏 | 1 套 | **约 ¥250**（用户询价，以官方店为准） | **已定：带 4.3″ 触摸屏的套餐**，显示直接用它（驱动复用官方 LCD 例程），不再买 OLED；认准正点原子官方店；资料随板，注意确认配的 USB 数据线类型（常见为方口线，手机线不一定能用） |
| 2 | MPU6050 模块 | GY-521 MPU6050 六轴模块 | 2 个 | ¥5–15/个 | 主传感器 + 1 个备件（几块钱，坏了好换）；买常见 GY-521 即可；**下单备注"两排排针焊好、朝上"**（便于热熔胶贴装与杜邦线，见 相关页面） |
| 3 | 12 V 直流小风扇 ✅已购 | 6cm 12V 散热风扇，小 4pin | 2 台 | ¥10–20/台 | 当前两台风扇均采三类；风扇 B 完全留出做泛化测试。 |
| 4 | 12 V 可调电源 ✅已购 | DC 12V 2A 可调电源 小4pin 一拖五 | 1 个 | ¥10–20 | **每次只运行 1 台被测风扇**（防多台振动/气流互扰，见 相关页面）→ 一拖一分线就够，一拖五也只接一路；供电上限同时 ≤3 台（4×0.5A≈2A 临界）；**若能调 6–12 V 就免买 LM2596** |
| 5 | 可调降压模块（LM2596） | LM2596S 降压模块 可调压 | 0–1 个（暂不买） | ¥3–6 | **等电源到手确认**：可调压→不买；固定 12 V→再买来做 6/9/12 V 分档 |
| 5b  | （按需）4pin 风扇延长线 | 4pin 风扇母对母延长线 | 0–2 条 | ¥3–8/条 | 公母不匹配/要加调速环节时用；可插拔方便换风扇做故障注入 |
| 6 | 继电器模块 | 5V 继电器模块 光耦隔离 1路 | 1 个 | ¥3–8 | 报警联动演示；看丝印确认高/低电平有效 |
| 7 | 面包板 + 杜邦线套装 | 面包板 830孔 + 杜邦线套装（母对母/公对公） | 1 套 | ¥10–25 | 搭电路；杜邦线多规格混装省心 |
| 8 | 热熔胶枪套装 | 热熔胶枪 小号 + 胶棒 | 1 套 | ¥15–25 | **固定传感器的关键工具**（相关页面），不要用双面胶 |
| 9 | （演示负载）12 V LED 灯带/灯珠 | 12V LED 灯带 红色 | 1 条 | ¥5–10 | 视频演示：报警时继电器断开它，观众看得清 |

> **OLED 已取消**：4.3″ 屏含在开发板套餐里，显示与驱动直接复用官方 LCD 例程。

**必买小计：约 ¥340–430**（含开发板与屏，不含 A.2 加购项；整机 ≤ ¥500 确认）

### 4.2 建议加购

| 物品 | 搜索关键词 | 参考价 | 用途 |
| --- | --- | --- | --- |
| 逻辑分析仪 | USB 逻辑分析仪 8通道 24M | ¥25–40 | 抓 I2C/串口/时序，排查疑难必备（配 Saleae Logic 上位机） |
| 洞洞板 + 排针 + 铜柱 | 洞洞板 7x9cm 单面 | ¥10–15 | 项目定型后把模块焊上去，样机更"成品"（需烙铁） |

### 4.3 已有或无需购买

**传感器固定耗材（建议加购，很便宜，见 相关页面）**：M2/M3 小螺丝 + 螺母套装、铝 L 角码 / 小固定片、（可选）3M VHB 强力双面胶、（可选）G 型夹/小台钳——用于把传感器装到**可移动测量夹具**上，不必每台风扇配 1 个传感器。

- **DAP 调试器**：你已有（CMSIS-DAP），SWD 四线接探索者板即可；若它实际是 ST-Link/J-Link 也同样能用，Keil 里对应选择调试器类型即可；
- 蜂鸣器：用探索者**板载 BEEP**，不用买模块；
- 万用表、手机充电头 + USB 数据线（给开发板供电）、烙铁（若做 A.2 洞洞板）、扎带若干。

### 4.4 下单与到手检查

1. 探索者板（**含 4.3″ 屏套餐**）在正点原子官方店下单，其余模块**同店凑单或一次性加购**省运费；
2. 到手核对：板卡型号 F407ZGT6、屏与配件齐全（资料、数据线）；
3. **通电前检查**：①万用表量 3.3 V / 5 V 对地不短路；②供电看清电压：GY-521 接 3.3 V、继电器模块接 5 V、风扇接 12 V；③风扇电源与开发板**共地**（避免测量时数值漂移）；④**插风扇前量 4pin 座 12V/GND 极性**防反接烧扇；
4. **风扇接线**：电源与风扇同为小 4pin → **配套"一拖五"分线直接对插**即可（有防呆卡扣）；公母不匹配就买 4pin 母对母延长线；自接线用杜邦母头+热缩管（单台 0.5A 足够），别用电工胶布裸接；
5. 到手先烧官方例程，按顺序验证：跑马灯/串口 → **LCD 显示例程点亮 4.3″ 屏** → DAP 下载链路正常，再进 D1 计划。
6. **风扇/电源联调顺序**：先只接 1 台风扇上电测转速与振动 → 再测各电压档（电源可调则直接调 6/9/12 V）→ 确认每台风扇都能稳定转再进数据采集。

---
