liyunlong-fred/motor-vibration-fault-detection/01_文档/项目规划/06_显示报警与交互.md

---
kb_id: PROJECT-UI-ALARM
kind: design
domain: firmware
lifecycle: current
authority: supporting
last_verified: 2026-09-24
migration_source: C:/Work/备份/电机振动故障检测/_Obsidian迁移前/_20260924/电机振动故障检测_项目规划.md
---

# 显示、报警与交互

## 1. 当前实现边界

屏幕页面、蜂鸣器、继电器和报警状态机尚未实现；本页只保留后续交互设计，不能据此表述为当前能力。

## 2. 交互设计

### 2.1 屏幕页面

- 页 1（默认，状态大字）：状态（正常/不平衡/机械松动）、置信度 %、f0=xx Hz、报警指示（异常时大字变红/闪烁）；
- 页 2：实时频谱（分辨率高，能直观看到"1× 峰"随贴片变大，演示效果最好）；
- 页 3：运行统计（已运行窗数、报警次数）。
- 刷新与采样分时：屏幕刷新放主循环低优先级，别抢占 DMA 采样时间片；屏驱动/画字直接用官方例程函数（lcd.c），触摸仅用于切页（也可用板载 KEY 代替）。

### 2.2 报警逻辑

- 判定异常需连续 ≥3/5 窗一致（投票）或概率 EMA 过阈值；
- 动作：蜂鸣器间歇 1 Hz 响；继电器吸合断开演示负载（或红灯）；屏幕状态大字变红/闪烁；
- 恢复：需连续 M 窗正常 **或** 按键手动复位，二选一（体现滞回概念）；
- 串口同时打印带时间戳的事件日志（`[t=123.4s] ALARM:unbalance p=0.93`），回放用；
- 调试期可先用板载 DS0/LED 闪烁 + BEEP 代替继电器，最后再挂继电器。

---
