liyunlong-fred/motor-vibration-fault-detection/01_文档/项目规划/07_里程碑与路线图.md

---
kb_id: PROJECT-ROADMAP
kind: design
domain: project
lifecycle: current
authority: supporting
last_verified: 2026-09-24
migration_source: C:/Work/备份/电机振动故障检测/_Obsidian迁移前/_20260924/电机振动故障检测_项目规划.md
---

# 里程碑与路线图

## 1. 当前推进顺序

原 12–14 天冲刺计划是历史估算。当前顺序为：重新烧录并板端/PC 对拍 → 确认机械 1× → 六面标定和夹具验证 → 三类正式采集和质检 → 特征、训练、部署、UI、报警。

## 2. 阶段计划

> 依据你的投入（每天 4–6 h，1–2 周）重排。原则：**先打通最小闭环，再补精致度**；每阶段有退出标准，跟不上就按"砍法"收缩范围，**不要拉长时间**。硬件到货前先做 **D0**；到货日 = D1 起点（Python 与例程已在 D0 备好，D1/D2 可合并推进）。

**D0｜到货前等货期（2–3 天，把"不插电也能做"的做完）**

- **P0 必做（≈半天）**：① 官网下载《探索者 STM32F407 开发指南》HAL 例程源码与视频；② Keil Pack Installer 装 **STM32F4xx_DFP** 器件包；③ 用 Keil 打开官方例程（跑马灯/串口/LCD 显示）**编译通过**——不烧录也要先编译，暴露缺包/版本等环境问题；④ 到资料里找是否有现成 **MPU6050/I2C 例程**，有则预习接线与代码结构（到货直接跑）。
- **P1 推荐（≈半天–1 天）**：⑤ 用"合成文件"模拟串口把练习 4 练掉一半——按 相关页面 帧格式写"按帧切块 + 转 int16"解析函数并用测试数据验证（这段代码将来就是 `make_dataset.py` 读文件的核心）；⑥ 在 `03_Python工具` 里搭 tools 骨架（collect.py / make_dataset.py 占位），把帧协议写成注释。
- **P2 有余力（≈1 天）**：⑦ 预习 MPU6050 寄存器关键页（WHO_AM_I=0x68、PWR_MGMT_1、ACCEL_CONFIG、ACCEL_XOUT_H、FIFO/ODR/DLPF）并画出"初始化→读原始值→FIFO 批量读"的寄存器流程；⑧ 预习 LCD 例程如何画大字/色块（D10 UI 用）；⑨ 装 STM32CubeProgrammer、STM32CubeMX 备用（D8–D9 才用）；⑩ 准备实验台：底座（木板/收纳盒）+ 扎带固定风扇框、热熔胶枪与胶棒就位、万用表/杜邦线归类。

| 天 | 内容（4–6 h） | 退出标准 |
| --- | --- | --- |
| D1 | 采购下单（探索者含屏套餐+12 V 小风扇×2–3+MPU6050 等）；官网下载《探索者开发指南》与例程；**Python 速成 3–4 h**（相关页面 路线）；以官方 HAL 例程为基底：点灯 + 串口 printf + **点亮 4.3″ 屏**（LCD 显示例程） | 板载 LED 亮、串口能打印、屏幕点亮 |
| D2 | I2C + MPU6050：读 WHO_AM_I、配量程/ODR/DLPF；轮询读原始加速度串口打印；在 CubeMX 里核对 I2C 引脚无冲突 | 数值随晃动/敲击明显变化 |
| D3 | FIFO/中断批量连续读 + 双缓冲；PC 波形实时显示脚本；采集模式帧协议雏形 | PC 画出 1 kHz 连续稳定波形 |
| D4 | CMSIS-DSP 移植 1024 点 FFT + Hann 窗 → PC 频谱图；用"贴片/敲击"验证谱峰可解释 | 频谱图可见 1× 峰随不平衡变大 |
| D5 | **数据采集冲刺(一)**：风扇 A 的正常、不平衡（胶带 2 档）、机械松动（M1 回退 1/4、1/2 圈）× 2–3 档电压；每个松动等级做恢复基线复测 | 三类均有可重复、可恢复的样本 |
| D6 | 风扇 B 按同一协议采三类，整台设备留出；完成质检并按设备生成 train/val/test 清单 | 数据集就绪、划分脚本跑通 |
| D7 | 特征脚本（与固件同参）→ 路线 A：特征 + MLP 训练 → confusion matrix 达标并记录数字 | 离线三分类基本可分（记录准确率） |
| D8 | （可选）路线 B：1D-CNN；int8 量化（PTQ）+ 导出 ONNX/TFLite；量化损失评估 | 量化后指标可接受 |
| D9 | CubeMX + X-CUBE-AI 导入模型生成 C → Keil 集成编译通过；同段数据 PC/板上数值一致性核对 | 板上输出概率与 PC 接近 |
| D10 | 在线闭环：采集→FFT→特征→推理→平滑决策状态机；屏幕状态大字页 + 板载 BEEP/LED（或继电器）；故障注入演练 | 贴片 → ≤2 s 报警 → 撕掉 → 恢复 |
| D11 | 泛化与实测：在留出风扇 B 上复测三类；测推理耗时/端到端延迟/RAM/Flash，回填 相关页面；连续运行 10 min 观察误报 | 相关页面 指标表填完（真实值） |
| D12–14 | 缓冲（前面若延迟在此消化）；GitHub 仓库（README/接线图/数据说明）；演示视频；简历文案与 Q&A 演练 | 成果物清单 相关页面 全部完成 |

**时间不够的砍法（按顺序砍，保主干）**：

1. 砍路线 B（1D-CNN）→ 只做特征 + MLP；
2. 减少电压档和故障等级，但保留正常 / 不平衡 / 机械松动三类；
3. 屏幕只做页 1（状态大字）；
4. 继电器先不用，用板载 LED + BEEP 演示报警；
5. 复杂松动等级只保留 M1 回退 1/4 圈这一档，优先保证重复装拆和恢复基线验证；
6. 风扇 B 的留出设备测试尽量保住；若没完成，只能报告同设备、按会话分组的结果，不能声称跨设备泛化。

> 若之后时间变充裕，可回到慢速版节奏把 1D-CNN、更多松动等级、更多设备和上位机仪表盘补上（见 相关页面 延伸方向）。

---
