liyunlong-fred/motor-vibration-fault-detection/01_文档/技术实施/硬件验证/风扇测速与机械基频确认.md

---
kb_id: HARDWARE-FAN-TACH-RUNBOOK
kind: procedure
domain: hardware
lifecycle: current
authority: supporting
last_verified: 2026-09-28
source_paths:
  - 06_笔记与踩坑/实验记录/E-01_风扇TACH逻辑分析仪测速.md
  - 05_演示与输出/logic_analyzer/20260928_fan_tach_edge_interval.png
---

# 风扇测速与机械基频确认

> [!note] 目标
> 用独立 TACH 测速确认机械 1×，并与同电压振动 FFT 对拍。2026-09-28 已完成 6 V、12 V 逻辑分析仪测速并确认本风扇为 2 脉冲/转；9 V 和同步频谱对拍仍待补充。

## 零、当前实测结论

逻辑分析仪测量相邻下降沿的平均周期，按已确认的 `PPR=2` 换算：

| 工况 | 平均 TACH 周期 | TACH 频率 | 机械 1× | 转速 |
|---|---:|---:|---:|---:|
| 6 V | 9.8 ms | 102.04 Hz | 51.02 Hz | 3061 RPM |
| 电压未标注的截图 | 6.881083 ms | 145.326 Hz | 72.663 Hz | 4360 RPM |
| 12 V | 5.45 ms | 183.49 Hz | 91.74 Hz | 5505 RPM |

6 V、12 V 波形占空比均约 50%。截图还给出高电平宽度 3.447333 ms，占空比为 50.10%。完整记录与限制见 [E-01 风扇 TACH 逻辑分析仪测速](../../../06_笔记与踩坑/实验记录/E-01_风扇TACH逻辑分析仪测速.md)。

当前不能再把既有 `36.6 Hz` 固定解释为机械 1×。如果周期 6.881083 ms 的截图与既有 `73.2 Hz` 频谱属于同一工况，那么实测机械 1× 为 72.663 Hz，`73.2 Hz` 更可能是 1×，而 `36.6 Hz` 更可能是约 0.5×。由于截图供电电压和既有振动文件尚未建立明确关联，该判断仍是条件结论。

### 零点一、下一轮变电压谱线跟踪

TACH 已能直接给出转速；变电压谱线跟踪现在用于把每档实测 1× 与振动峰对应起来，而不再用于单独猜测绝对转速。

1. 保持风扇、底板、传感器和紧固状态不变，正常工况下分别采 6 V、9 V、12 V；每档稳定 20～30 秒后采至少 20 帧。
2. 对每档运行 `harmonics.py`，把同工况 TACH 测得的 RPM 一并传入（或在采集时写入 CSV 的 `rpm_measured`）：

```powershell
python -B 03_Python工具\harmonics.py <6V实际CSV路径> --rpm-measured 3061 --plot
python -B 03_Python工具\harmonics.py <9V实际CSV路径> --rpm-measured <9V实测RPM> --plot
python -B 03_Python工具\harmonics.py <12V实际CSV路径> --rpm-measured 5505 --plot
```

3. 把三个电压下同步向高频移动的一组谱线与同档 TACH 机械 1× 对齐；6 V 应在约 51.02 Hz，12 V 应在约 91.74 Hz，9 V 使用补测值。
4. 若 2× 比 1× 强，不要直接把最强峰当 f0；工具会以 TACH 的 `RPM/60` 锁定 1×，再判断各谱峰属于 1×、2×还是其他阶次。默认频谱估计只会从约 50–100 Hz 的已验证机械 1×范围内选峰，不能把 36.6 Hz 一类子谐波回推为 f0。
5. 在正常、不平衡、机械松动三类中使用同一个 f0 估计规则。标签来自受控工况，不来自“哪根峰看起来像故障”。

验收条件：三档电压都有带标签的 TACH 平均值和同工况振动数据；FFT 中的 1× 候选与 TACH 机械 1× 相差不超过一个 FFT bin（约 0.98 Hz），或能用转速波动和采集不同步合理解释。若候选族不唯一，就先把对应谱峰标为未确认。

## 一、接线

前提：已经确认风扇确实有独立TACH线。

全部断电后连接：

```text
风扇电源 +12V ───────── 风扇 +12V

风扇电源 GND ───┬───── 风扇 GND
               └───── 逻辑分析仪 GND

3.3V ── 4.7kΩ ──┐
                ├───── 风扇 TACH
                └─1kΩ─ 逻辑分析仪 CH0

风扇 PWM ───────── 保持原接法
```

注意：

- 风扇继续由独立电源供电。
- 逻辑分析仪必须和风扇共地。
- TACH上拉到3.3 V，不要上拉到12 V。
- 不要把风扇12 V电源线接入逻辑分析仪。
- 逻辑分析仪是否允许3.3 V输入，需要看型号规格；绝大多数可以，但不能假定它耐受12 V。
- 逻辑分析仪如果提供“3.3 V输出”，也要确认该针脚确实是电源输出且允许外接上拉。最稳妥的是使用开发板的3.3 V或独立3.3 V电源，只给4.7 kΩ上拉使用。
- 建议CH0前串1 kΩ保护电阻。

如果未上拉时测得TACH对地明显高于3.6 V，先不要连接分析仪，需要检查是否认错针脚或风扇存在内部高压上拉。

## 二、逻辑分析仪设置

推荐参数：

```text
通道：CH0
采样率：1 MHz
采样时间：5～10秒
触发：下降沿
数字阈值：3.3 V/CMOS模式（如果软件可选）
```

测速信号一般只有几十到一百多Hz，实际上100 kHz采样率已经足够；设置1 MHz便于观察毛刺和边沿质量。

启动顺序：

1. 风扇和分析仪都断电。
2. 完成接线。
3. 启动逻辑分析仪软件。
4. 开始采集。
5. 再打开风扇电源。
6. 风扇稳定20～30秒后，再采一段5～10秒的稳定波形。

## 三、怎样从波形计算RPM

测量两个相邻同类型边沿之间的时间：

```text
下降沿 → 下一个下降沿
```

记周期为`T`秒：

```text
TACH频率 = 1 / T
RPM = TACH频率 × 60 / 每转脉冲数
```

本项目风扇已确认为每转2脉冲，因此：

```text
RPM = TACH频率 × 30
RPM = 30 / T
```

本次截图的实测换算为：

```text
相邻下降沿间隔 T = 6.881083 ms
TACH频率 = 1 / 0.006881083 = 145.326 Hz
RPM = 145.326 × 30 = 4359.8 rpm
机械1× = 145.326 / 2 = 72.663 Hz
```

因此不能把 TACH 脉冲频率直接当成机械 1×，也不能继续沿用原先基于假设周期得出的 `36.6 Hz=1×` 结论。

## 四、推荐的实际测量流程

分别测：

```text
6 V、9 V、12 V
```

每档执行：

1. 风扇固定方式不变。
2. 不贴胶带，先测正常状态。
3. 调整电压。
4. 等待20～30秒稳定。
5. 采集5～10秒TACH波形。
6. 在稳定区任选10个以上完整周期。
7. 使用软件计算平均频率，或者计算：

```text
平均周期 = 选中时间长度 / 完整周期数
```

8. 记录：

| 电压 | 周期数 | 总时间 | 平均周期 | TACH频率 | RPM | 机械1× |
|---|---:|---:|---:|---:|---:|---:|
| 6 V | 已取稳定区平均 | 未记录 | 9.8 ms | 102.04 Hz | 3061 rpm | 51.02 Hz |
| 9 V |  |  |  |  |  |  |
| 12 V | 已取稳定区平均 | 未记录 | 5.45 ms | 183.49 Hz | 5505 rpm | 91.74 Hz |

9. 再贴胶带重复测量，确认胶带是否导致转速变化。

不要只量一个周期，因为电机换相、控制器调速和边沿抖动会带来小误差。测10～50个周期取平均更可靠。

## 五、波形应该是什么样

正常情况：

```text
3.3V ─────┐     ┌────────┐     ┌────────
           │     │        │     │
0V         └─────┘        └─────┘
            <---  T  --->
```

判断：

- 周期基本均匀：正常。
- 偶尔出现非常窄的脉冲：可能有干扰，计算时应排除。
- 电平始终为高：没有TACH脉冲、没有共地或针脚错误。
- 电平始终为低：接错线、TACH被短路或转子恰好停在拉低状态。
- 周期忽长忽短：接触不良、风扇调速不稳定或分析仪阈值不合适。
- 一个正常周期中出现多个细小跳变：增加数字去毛刺，检查地线和线长；必要时在TACH节点增加约1 nF到地的小电容。

## 六、一个重要限制

逻辑分析仪直接测到的是“每秒多少个 TACH 脉冲”。本风扇的 PPR 已确认为 2，因此当前可换算真实 RPM；如果更换风扇，必须重新核对新风扇 PPR，不能继承本记录。

占空比约 50% 只能说明输出波形近似对称，不能单独证明 PPR。七片叶片只决定叶片通过频率 `BPF=7×机械1×`，也不能用来推断 PPR。

## 七、是否还需要STM32测速

当前基频确认阶段可以完全不用STM32测速：

```text
逻辑分析仪测速（2 PPR） → 得到机械1× → 与同电压FFT对拍
```

确认基频后，如果最终产品界面需要实时显示RPM，或者希望每份CSV自动记录转速，再把同一根TACH线接入STM32的PA5/TIM2_CH1即可。

当前先补齐带电压标签的 9 V TACH，并重新完成“6 V、9 V、12 V 正常基线 + 同工况 TACH/FFT 对拍”。6 V 和 12 V 已由“估计 f0”升级为“实测机械 1×”；历史振动文件在没有同步关系时仍不得回填实测 RPM。
