liyunlong-fred/motor-vibration-fault-detection/01_文档/项目规划/README.md

---
kb_id: PROJECT-PLANNING-NAV
kind: overview
domain: project
lifecycle: current
authority: canonical
last_verified: 2026-09-24
---

# 项目规划

这里是项目规划的现行维护入口。各页于 2026-09-24 由历史总稿完整迁入，运行事实仍以源码、配置、数据和知识库当前状态为准。

## 1. 规划主题

- [项目章程与验收](00_项目章程与验收.md)
- [技术原理与设计边界](01_技术原理与设计边界.md)
- [总体方案与数据流](02_总体方案与数据流.md)
- [硬件方案、接线与采购](03_硬件方案_接线与采购.md)
- [固件与 PC 软件架构](04_固件与PC软件架构.md)
- [数据集设计与采集计划](../../04_数据集/数据集设计与采集计划.md)
- [模型训练与边缘部署](05_模型训练与边缘部署.md)
- [显示、报警与交互](06_显示报警与交互.md)
- [里程碑与路线图](07_里程碑与路线图.md)
- [简历答辩与学习路线](08_简历答辩与学习路线.md)
- [风险、扩展与参考资料](09_风险扩展与参考资料.md)
- [项目决策登记](10_项目决策登记.md)
- [调试组件：USMART](11_调试组件_USMART.md)

## 2. 关联入口

- [当前状态](../../知识库/10_当前状态.md)
- [系统地图](../../知识库/20_系统地图.md)
- [决策索引](../../知识库/30_决策索引.md)
- [问题与实验索引](../../知识库/40_问题与实验索引.md)
- [开发问题记录](../../06_笔记与踩坑/开发问题/README.md)

## 3. 历史来源

历史总稿位于 C:\Work\备份\电机振动故障检测\_Obsidian迁移前\_20260924\电机振动故障检测_项目规划.md，仅用于追溯，不再维护。
