liyunlong-fred/motor-vibration-fault-detection/知识库/30_决策索引.md

---
kb_id: DECISION-INDEX
kind: decision
domain: project
lifecycle: current
authority: supporting
last_verified: 2026-09-28
---

# 决策索引

本页只提供路由，详细原因和证据保留在原文中。

| 决策 | 当前口径 | 依据 |
|---|---|---|
| 主分析量 | 使用加速度谱，不以二次积分位移谱作为主特征 | [Q-01](../06_笔记与踩坑/开发问题/Q-01_加速度谱与位移谱.md) |
| 测量轴 | X 为振动测量轴；Y 为静态安装重力参考轴，须记录正负号 | `config.json`、`metadata.py` |
| IIC 引脚 | 软件 IIC，SCL=PB6、SDA=PB7；不改回 PB8/PB9 | [Q-04](../06_笔记与踩坑/开发问题/Q-04_IIC三轴整值错乱.md)、iic.h |
| 采样与 FFT | 1 kHz、1024 点、Hann、单边幅值谱 | `app_config.h`、`dsp_fft.c` |
| 机械基频口径 | 风扇 TACH 已确认为 2 脉冲/转；相邻同类边沿频率除以 2 才是机械 1×，RPM=`f_tach×30` | [E-01 TACH 测速](../06_笔记与踩坑/实验记录/E-01_风扇TACH逻辑分析仪测速.md) |
| 历史谱峰解释 | 在同电压 TACH/FFT 对拍完成前，不再把 36.6 Hz 固定视为 1×；截图工况按 2 PPR 计算的 1× 为 72.663 Hz | [测速与基频确认](../01_文档/技术实施/硬件验证/风扇测速与机械基频确认.md) |
| 数据标签 | 客观工况、目标标签、依据和可信度分开保存 | [数据集契约](../04_数据集/README.md) |
| 第三类故障 | 使用安装固定处机械松动 looseness；轴承异常不在项目范围内 | [Q-05](../06_笔记与踩坑/开发问题/Q-05_第三类故障改为机械松动.md)、[数据集契约](../04_数据集/README.md) |
| 松动注入 | 固定底板不变，只改变指定安装紧固点；记录紧固点编号和回退圈数或间隙 | [采集操作手册](../04_数据集/采集操作手册.md) |
| 正式数据准入 | 仅 `formal + quality_status=pass` 进入训练清单 | `make_dataset.py` |
| 运行架构 | 裸机主循环即可，当前不引入 FreeRTOS | [总体方案与数据流](../01_文档/项目规划/02_总体方案与数据流.md) |
| 知识库 | 仓库根目录是唯一 Vault；历史快照不作为当前状态 | [知识库导航](00_导航.md) |
