liyunlong-fred/motor-vibration-fault-detection/知识库/_generated/检查报告.md

# 知识库检查报告

> 由 `python -B 03_Python工具/kb_index.py build` 生成，请勿手工编辑。

- 状态：通过
- 受管文档：39
- 关键模块：13
- 重要附件：6
- formal CSV：14
- 问题数：0

## 检查结果

- 未发现结构、索引、链接或 manifest 一致性问题。
