liyunlong-fred/motor-vibration-fault-detection/01_文档/项目规划/08_简历答辩与学习路线.md

---
kb_id: PROJECT-CAREER-LEARNING
kind: reference
domain: project
lifecycle: current
authority: supporting
last_verified: 2026-09-24
migration_source: C:/Work/备份/电机振动故障检测/_Obsidian迁移前/_20260924/电机振动故障检测_项目规划.md
---

# 简历答辩与学习路线

## 1. 当前使用边界

简历只能引用已有采样、FFT、串口链路和历史对拍证据。模型精度、推理耗时、报警延迟、屏幕展示和正式数据统计均未产生当前可引用证据。分类名称统一为安装固定处机械松动。

## 2. 简历与答辩

### 2.1 简历模板

> **低成本边缘端电机振动故障检测系统（STM32 + TinyML）**｜独立开发
> 
> - 面向小型电机/风扇离线巡检场景，设计"采集→FFT→特征→推理→报警"闭环：以 1 kHz 采样 MPU6050 加速度信号，CMSIS-DSP 实现 1024 点加窗 FFT 频谱分析；
> - 自建打标数据集（2 台 12 V 直流风扇、3 类〔正常/不平衡/安装固定处机械松动〕，约【X】万窗；1 台设备完全留出验证），离线测试准确率【Y】%，int8 量化后【Z】%；
> - 部署轻量级神经网络至 **正点原子探索者 STM32F407（Cortex-M4F @168 MHz）** 本地离线推理（X-CUBE-AI，模型 ROM【A】KB / RAM【B】KB），单帧处理耗时【C】ms（实测），端到端报警延迟 ≤【D】s（实测）；连续运行 10 min 零误报【实测条件】；
> - 4.3″ 彩色触摸屏实时显示状态/置信度/实时频谱，蜂鸣器 + 继电器联动报警（多窗投票 + 滞回防抖）；整机成本约【E】元（含屏开发板约 ¥250）。

### 2.2 诚信原则

- 凡是"延迟/准确率/误报"数字**必须来自你的实测或离线评估**，且能当场复现；

- 描述用词准确：数据是**自建受控故障样本**，机械松动仅指安装固定处；系统定位是**方法验证/演示级**，不要写成"已量产部署在产线"；

- 面试被追问数据来源时，直接讲采集矩阵与局限（相关页面 口径），反而建立信任。

### 2.3 高频问题与答复要点

| 可能的问题 | 应答要点 |
| --- | --- |
| 为什么用频域不用时域？ | 特征物理意义明确、抗安装差异、对小型模型更友好（相关页面） |
| 为什么不在云端/上位机做 AI？ | 离线场景：数据不出厂、无网络延迟与成本、隐私合规、断网可用 |
| 采样率为何 1 kHz？带宽够吗？ | 对象是低转速风扇；Nyquist+DLPF 约束；承认局限并给出宽带宽传感器升级路径（相关页面） |
| 为什么选 F407 而不是 F103？ | F103（M3）无 FPU/DSP，推理偏慢；F407（M4F 168 MHz）跑量化模型余量大，X-CUBE-AI 官方支持；选正点原子板是因为教程/Keil 生态一致，开发效率高 |
| 模型多大？为什么量化？ | 用 X-CUBE-AI 报告与实测 RAM/ROM 回答；int8 减小 4× 并提速，量化损失可控 |
| 转速漂移怎么办？ | 特征相对化 + 自动基频估计；进阶用阶次分析（order tracking） |
| 换一台没见过的设备还能准吗？ | 明确讲：风扇 B 完全留出的测试结果；同时承认只有两台设备，仍需更多设备验证 |
| 误报怎么处理？ | 多窗投票、概率 EMA、滞回阈值、置信度下限 |
| 机械松动标签凭什么可信？ | 指定紧固点按圈数/间隙受控注入，并做“松动→恢复紧固→回到基线”的往返重复验证 |
| FFT 里加窗是为什么？ | 泄漏与旁瓣、Hann 窗、幅度修正概念（背熟） |
| 你踩过最大的坑？ | 从 D3–D10 的日志里挑一个真实问题（如采样丢点/假 FFT/训练与部署特征不一致），按"现象→排查→解决→沉淀"讲 |

### 2.4 后续加分项

- GitHub 仓库规范（README 含图与指标表、目录清晰、能复现）；
- 演示视频 1–2 分钟 + 数据可视化截图；
- 一篇笔记/博客：从"信号链路设计"或"TinyML 踩坑"角度写（体现总结能力）；
- 泛化测试：留出设备的 confusion matrix（证明你没过拟合一台风扇）。

---

## 3. 学习路线

结合你现有的基础（F103 HAL 实验：串口、按键中断、点灯），建议按"用到再学、学过即用"补：

| 主题 | 本项目用到 | 学习入口建议 |
| --- | --- | --- |
| I2C 总线 | MPU6050 读写（4.3″ 屏不走 I2C） | 你的知识库笔记 + 正点原子《探索者开发指南》I2C 章节；逻辑分析仪抓波形理解时序 |
| 中断与 NVIC | FIFO 水印中断、按键 EXTI | 已做过按键中断实验，直接复用概念 |
| DMA | I2C/UART 搬运、双缓冲 | 结合 HAL 例程学"外设→内存"不占 CPU |
| 定时器 | 采样节拍/看门狗心跳 | 已具备基础 |
| 显示屏驱动 | 点亮 4.3″ 屏、画大字/频谱（照官方例程）  | 《探索者开发指南》LCD 显示实验章节 |
| 信号与系统基础 | 采样定理、DFT/FFT、泄漏与窗 | B 站《傅里叶变换》可视化视频 + scipy 动手算 |
| CMSIS-DSP | arm_rfft_fast_f32 等 | ARM 官方文档 + 例程（相关页面） |
| Python/numpy/scipy | 采集、FFT 对照、画图（见下） | 见下方"Python 最小学习路线" |
| 机器学习基础 | 数据划分、混淆矩阵、过拟合 | 吴恩达 ML 课或西瓜书前几章，够用即可 |
| TinyML/模型部署 | 量化、X-CUBE-AI | X-CUBE-AI 官方文档/视频；《TinyML》一书可选 |
| Git/GitHub | 代码与数据集管理 | 用起来即学，遇到再查 |

> 提醒：**不要先系统性学完再动手**。以 D1–D14 里程碑为驱动，缺什么补什么，2 周内就能滚出完整项目；系统性补课放到项目之后。

### 3.1 Python 最小学习路线

先用一张表讲清楚"哪些环节**必须写 Python**、写多少"：

| 环节（对应天数） | 用 Python 做什么 | 难度/时长 | 能否绕开 |
| --- | --- | --- | --- |
| 数据采集（D3–D6） | 用 pyserial 收串口原始数据、按标签存文件 | ★☆ 半天 | 可先用串口助手手动存盘，但批量打标/管理仍要脚本 |
| 可视化（D3–D4） | matplotlib 画实时波形/频谱图 | ★☆ 半天 | 可先看现成工具，但训练后画混淆矩阵仍需 |
| 数据集切窗 + 特征（D6–D7） | numpy 切窗、算特征、保存 npz | ★★ 半天 | **否**（与固件同源的关键环节） |
| 模型训练（D7–D8） | scikit-learn / PyTorch 训练与评估 | ★★★ 1 天  | 可换 Edge Impulse 网页版训练（代价：自定义度低、简历含金量略降） |
| 量化导出（D8） | 转 ONNX/TFLite 脚本 | ★ 照抄示例即可 | 否，但基本是"抄官方示例改路径" |

**最小学习路线（D1 花 3–4 小时，之后按需查资料）**：

1. **语法速成**：变量/类型、if、for/while、函数、列表与字典、字符串、文件读写 —— 约 2 h（菜鸟教程或廖雪峰教程前 1/3 即可）；
2. **numpy**：数组创建/索引/切片/简单运算/reshape —— 1 h（本项目所有数据都是数组）；
3. **matplotlib**：画一条曲线、两幅子图（波形 + 频谱）—— 0.5 h；
4. **pyserial**：打开串口、读 N 字节、打印/存盘 —— 0.5 h；
5. **明确不学**：类与面向对象、装饰器、多线程、pandas、爬虫、Web——本项目用不到，先跳过。

> 配合方式：本项目所有 `tools/*.py` 脚本可以交给 AI 助手**逐段讲解并带你改写**；你的目标是"能读懂 + 能改参数"，不必追求独立从零写出。
> 
> 完整的分阶段学习流程（每个知识点标注 🔥着重 / ⏱️略读 / ⛔跳过）见下方 **14.2**。

### 3.2 Python 学习全流程

**三档标注说明**

| 标注 | 含义 | 学习策略 |
| --- | --- | --- |
| 🔥 着重学  | 本项目反复用，不掌握后面会卡壳 | 动手敲代码 + 做练习，务必掌握 |
| ⏱️ 快速略读 | 知道存在、看得懂、能照抄即可  | 浏览示例一遍，不深究 |
| ⛔ 直接跳过  | 本项目第 1 轮用不到 | 不花时间，踩到坑再回来查 |

- **时间预算**：速成版 ≈3–4 h（只做 🔥）；从容版 ≈8–10 h（🔥 + ⏱️）；⛔ 两种版本都不碰。
- **每天怎么用**：D1 只做"环境 + 阶段 1 语法"；numpy（阶段 2）和串口（阶段 4）放到 D3–D6 用中学；matplotlib（阶段 3）在 D3–D4 出图时用；训练与评估（阶段 5）到 D7–D8 再学。

**环境准备（≈0.5 h，🔥）**

- 安装 Python 3.10+（Miniconda 或官网安装包），用 pip 装：`numpy scipy matplotlib pyserial scikit-learn`；
- 编辑器用 VSCode（装 Python 插件）即可；
- 自检：`python -c "import numpy; print(numpy.__version__)"` 不报错。
- ⛔ 不学：pip 高级用法、虚拟环境原理（会照命令装包即可）。

**阶段 1｜语法基础（≈2 h，🔥 为主）**

| 知识点 | 标注  | 学时 | 本项目哪里用 |
| --- | --- | --- | --- |
| 变量与基本类型（int/float/str/bool） | 🔥  | 10 min | 到处都是 |
| f-string 打印（`f"...{x}"`） | 🔥  | 10 min | 串口日志、文件名带标签 |
| if / for / while / range | 🔥  | 30 min | 遍历样本、循环采集 |
| 列表 list（追加/索引） | 🔥  | 15 min | 临时存数据 |
| **列表切片 `[start:stop:step]`** | 🔥  | 15 min | **切窗的核心操作** |
| 字典 dict | 🔥  | 20 min | 类别号↔名字映射、参数表 |
| 函数 def / return / 默认参数 | 🔥  | 30 min | 把采集/切窗/特征封装成函数 |
| 字符串方法（format/split/strip/encode） | 🔥  | 15 min | 文件名、收发指令文本 |
| 文件读写（open/with） | 🔥  | 20 min | 原始数据落盘 |
| bytes / bytearray / int.from_bytes | 🔥  | 20 min | **串口来的就是字节**，解析必备 |
| import / if `__name__ == "__main__"` | 🔥  | 10 min | 脚本组织 |
| 异常 try/except | ⏱️  | 10 min | 拔串口线/读文件失败不崩 |
| 元组 / 集合 / 推导式 / lambda | ⏱️  | 15 min | 看得懂官方示例即可 |
| None、作用域、全局变量 | ⏱️  | 10 min | 偶尔遇到 |
| 中文编码 utf-8 / 乱码 | ⏱️  | 5 min  | 打印中文不乱码 |
| 类 class（面向对象） | ⛔ | — | 只需懂"对象.方法"（如 `arr.mean()`）即可 |
| 装饰器 / 生成器 / async / 多线程 | ⛔ | — | 本项目用不到 |
| 正则 re | ⛔ | — | 第一轮跳过，字符串 split 够用 |

**阶段 2｜numpy（≈1.5–2 h，🔥 数据处理核心）**

| 知识点 | 标注  | 学时 | 本项目哪里用 |
| --- | --- | --- | --- |
| 创建数组：np.array / zeros / arange / reshape | 🔥  | 25 min | 波形数组容器 |
| 索引 / 切片 / 布尔选择 | 🔥  | 20 min | 截取一段数据、按条件取样本 |
| 数学与统计：mean / std / sum / max / argmax / 平方 / sqrt | 🔥  | 20 min | RMS、峭度、谱峰等特征 |
| **np.frombuffer（字节→int16 数组）** | 🔥  | 10 min | **串口二进制直接转数组，本项目核心技巧** |
| np.fft.rfft / fftfreq（会用即可） | 🔥  | 20 min | 离线复算频谱、与固件结果对照 |
| 保存/读取：np.save / np.load / .npz | 🔥  | 10 min | 数据集的标准格式 |
| 轴 axis 与广播 broadcast | ⏱️  | 20 min | 看懂 `mean(axis=1)`；报错会查 |
| np.random（加噪/打乱） | ⏱️  | 10 min | 数据增强（可选） |
| 排序 / where | ⏱️  | 10 min | 偶尔用 |
| 矩阵求逆/特征值等线性代数深水区 | ⛔ | — | 用到再查 |

**阶段 3｜matplotlib（≈0.5–1 h，会用就行）**

| 知识点 | 标注  | 学时 | 本项目哪里用 |
| --- | --- | --- | --- |
| plot / xlabel / ylabel / title / legend / show | 🔥  | 15 min | 画波形与频谱 |
| subplots 多子图 | 🔥  | 10 min | 上面波形、下面频谱并排 |
| 实时刷新（交互模式/animation） | ⏱️  | 20 min | 也可用现成 SerialPlot 替代，二选一 |
| 中文字体乱码处理 | ⏱️  | 10 min | 图上显示中文标签 |
| 颜色/标记/样式美化、高清导出 | ⛔ | — | 默认样式够用 |

**阶段 4｜串口与采集脚本（≈1 h，🔥；D3–D6 用中学）**

| 知识点 | 标注  | 学时 | 本项目哪里用 |
| --- | --- | --- | --- |
| pyserial：serial.Serial / 读 / 写 / 超时 | 🔥  | 30 min | 采集工具核心 |
| 帧协议解析（找帧头、切包、CRC 可后补） | 🔥  | 30 min | 配合 相关页面 的帧格式 |
| struct 打包/解包 | ⏱️  | 20 min | 多数情况用 np.frombuffer 更省事 |
| pandas | ⛔ | — | 本项目 numpy 足够 |
| argparse 命令行参数 | ⏱️  | 15 min | 可选：脚本参数化 |

**阶段 5｜训练与评估（第 7–8 天才学，≈2–3 h，🔥 概念为主）**

| 知识点 | 标注 | 说明 |
| --- | --- | --- |
| 训练/验证/测试集切分（train_test_split） | 🔥 | 决定评估是否可信（相关页面） |
| 混淆矩阵 / 准确率 / 每类召回率 | 🔥 | 面试谈"数据"必用（相关页面） |
| 标准化/归一化概念 | 🔥 | 必须与固件侧特征缩放一致 |
| scikit-learn 的 MLPClassifier 照模板跑通 | 🔥（优先于 PyTorch） | 路线 A 的落地方案 |
| PyTorch 基础 | ⏱️ 可选 | 只有做路线 B（1D-CNN）才需要，照官方模板改 |
| 过拟合 / 偏差-方差 | ⏱️ | 概念了解即可 |

**练习自检（把每个 🔥 变成"我敲过"）**

1. 用 Python 写 10 个 int16 数到文件，再读回来打印长度、均值、最大值；
2. 用 numpy 生成 1 秒、1000 Hz 采样、频率 25 Hz 的模拟正弦波，算出 FFT 峰值频率 ≈ 25 Hz；
3. 写一个函数把标签 `normal/unbalance/looseness` 映射为 0/1/2，并遍历打印；
4. 用 pyserial 从串口读一段字节，`np.frombuffer` 转成 int16 数组；
5. 画两幅子图：上波形、下频谱。

> 全部脚本我会陪你逐段写；上面 5 题做完，本项目需要的 Python 关就过了。⛔ 清单项目一律"踩到坑再回来补"。

---
