liyunlong-fred/motor-vibration-fault-detection/01_文档/项目规划/10_项目决策登记.md

---
kb_id: PROJECT-DECISIONS
kind: decision
domain: project
lifecycle: current
authority: supporting
last_verified: 2026-09-24
migration_source: C:/Work/备份/电机振动故障检测/_Obsidian迁移前/_20260924/电机振动故障检测_项目规划.md
---

# 项目决策登记

## 1. 当前决策

已生效决策：软件 IIC PB6/PB7；1 kHz、1024 点、Hann；X 测量轴/Y 重力轴；normal/unbalance/looseness；schema v3；仅 formal 且 quality_status=pass 进入训练；风扇 B 完全留出；暂不引入 FreeRTOS。详见[决策索引](../../知识库/30_决策索引.md)。

## 2. 决策登记

| # | 决策项 | 状态 | 结论 |
| --- | --- | ----- | --- |
| 1 | 主控平台 | ✅ 已定  | 购入**正点原子探索者 STM32F407ZGT6（含 4.3″ 触摸屏套餐）**，用户已询到约 ¥250（以官方店为准）；原 F103 板留作过渡 |
| 2 | IDE | ✅ 已定  | **Keil5 不变**；CubeMX 仅做初始化与 X-CUBE-AI 导入 |
| 3 | 部署工具 | 🟡 默认 | **X-CUBE-AI**（新手向，与 CubeMX+Keil 流程无缝）；到 D8–D9 视情况再评估 TFLite Micro |
| 4 | 预算 | ✅ 已定  | 板+屏套餐约 ¥250 ＋ 板外模块约 ¥50–140 → **整机约 ¥300–400，≤ ¥500** |
| 5 | 时间投入 | ✅ 已定  | 每天 4–6 h、1–2 周 → 相关页面 的 D1–D14 冲刺版（含砍法预案） |
| 6 | Python | ✅ 已定  | 零基础 → 相关页面 最小学习路线（D1 花 3–4 h） |
| 7 | 类别命名 | ✅ 已定  | **3 类：正常 / 不平衡 / 机械松动**；松动限定为安装固定处异常，轴承异常不保留（口径见 相关页面 / 相关页面 Q-05） |
| 8 | 数据集建设  | ✅ 已定  | 现有 2 台 12 V 直流风扇均采三类受控工况；风扇 B 完全留出评估跨设备泛化 |
| 9 | 调试器 | ✅ 已定  | **已有 DAP（CMSIS-DAP）**：SWD 四线接探索者板，Keil5 选 CMSIS-DAP 调试器，无需另购 |
| 10  | 显示方案 | ✅ 已定  | 套餐 **4.3″ 彩色触摸屏**：UI 直接画在屏上（复用官方 LCD 例程驱动），**不再购买 OLED** |
| 11  | 标签与数据归档 | ✅ 已定 | 采用 schema v3 结构化元数据；X 为振动测量轴、Y 为重力轴；松动记录紧固点和回退圈数/间隙；正式数据进 `formal/ + manifest.csv`，调试数据留 `debug_raw/` |

---
