liyunlong-fred/motor-vibration-fault-detection/知识库/模板/实验记录.md

---
kb_id: ""
kind: experiment
domain: project
lifecycle: draft
authority: supporting
last_verified: "{{date:YYYY-MM-DD}}"
---

# {{title}}

## 目的与假设

## 环境与版本

- 日期：{{date:YYYY-MM-DD}}
- 固件提交：
- 设备 / 会话：
- 电压 / 采样参数：

## 步骤

## 原始证据

## 结果

## 结论与限制

## 后续动作
