liyunlong-fred/motor-vibration-fault-detection/知识库/模板/技术决策.md

---
kb_id: ""
kind: decision
domain: project
lifecycle: draft
authority: supporting
last_verified: "{{date:YYYY-MM-DD}}"
---

# {{title}}

## 背景

## 可选方案

## 决策

## 原因与取舍

## 证据

## 后续影响
