liyunlong-fred/motor-vibration-fault-detection/05_演示与输出/20260921_172553_notag_Z_f0001-0020_spectrum.png

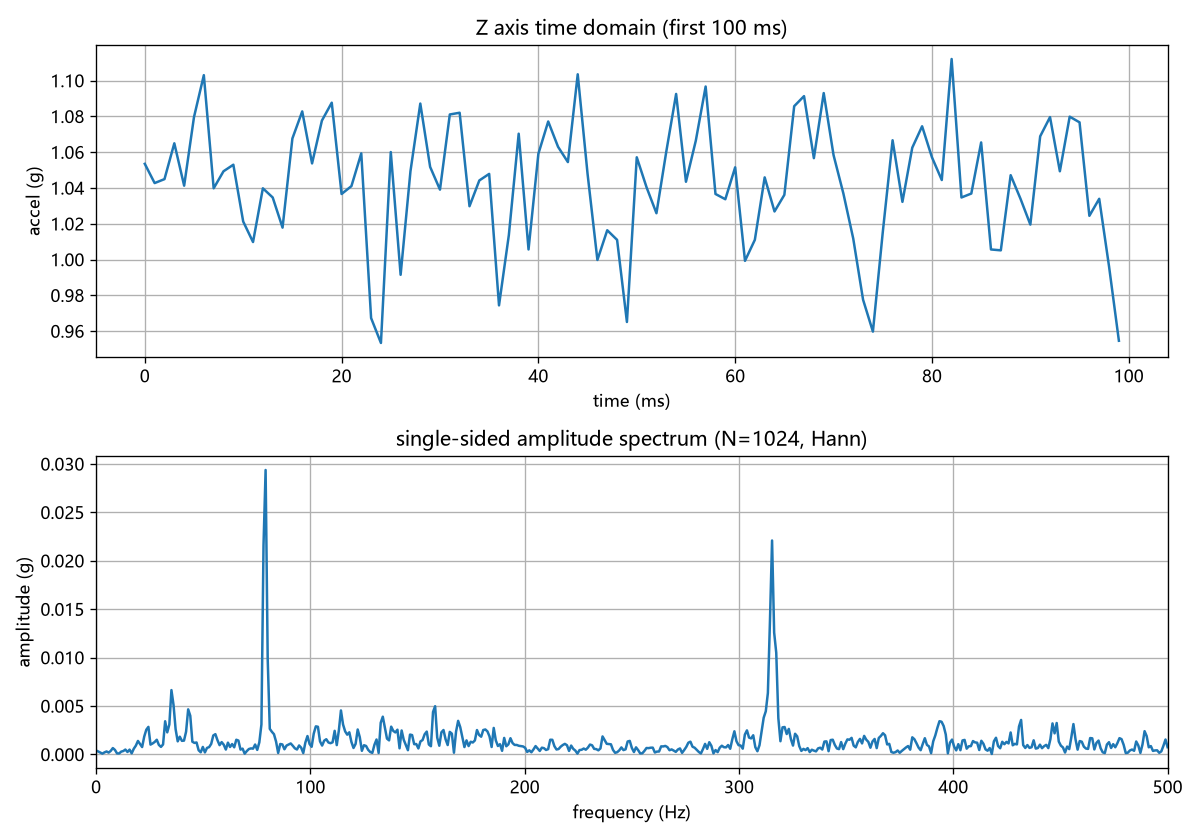
05_演示与输出/20260921_172553_notag_Z_f0001-0020_spectrum.png
