liyunlong-fred/motor-vibration-fault-detection/05_演示与输出/20260922_150613_fan9v_normal_X_f0001-0020_spectrum.png

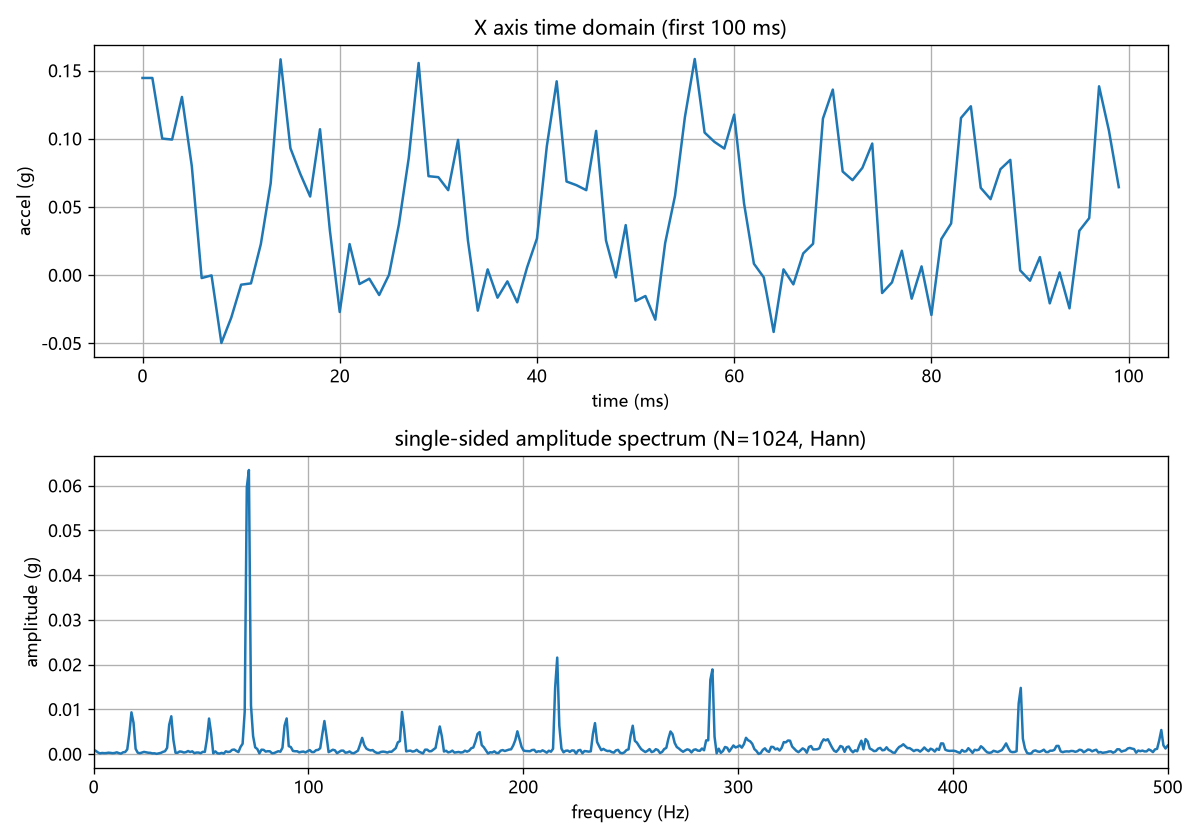
05_演示与输出/20260922_150613_fan9v_normal_X_f0001-0020_spectrum.png
