liyunlong-fred/motor-vibration-fault-detection/05_演示与输出/20260922_150613_vs_145044_tape_compare.png

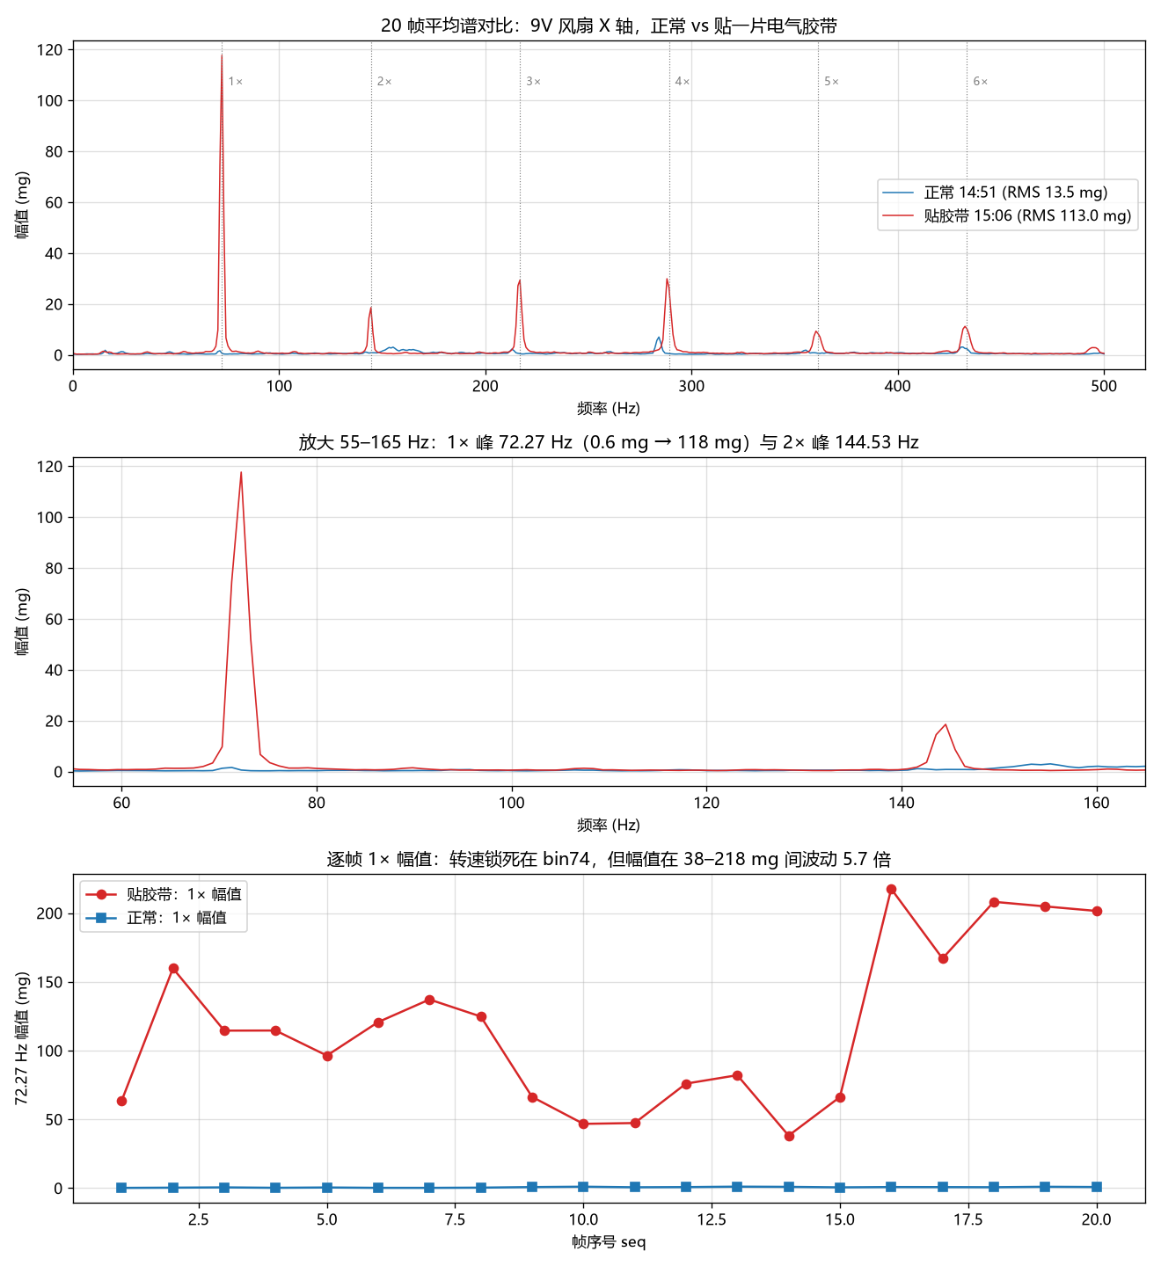
05_演示与输出/20260922_150613_vs_145044_tape_compare.png
