liyunlong-fred/motor-vibration-fault-detection/05_演示与输出/20260922_151952_tape_0_1_2_compare.png

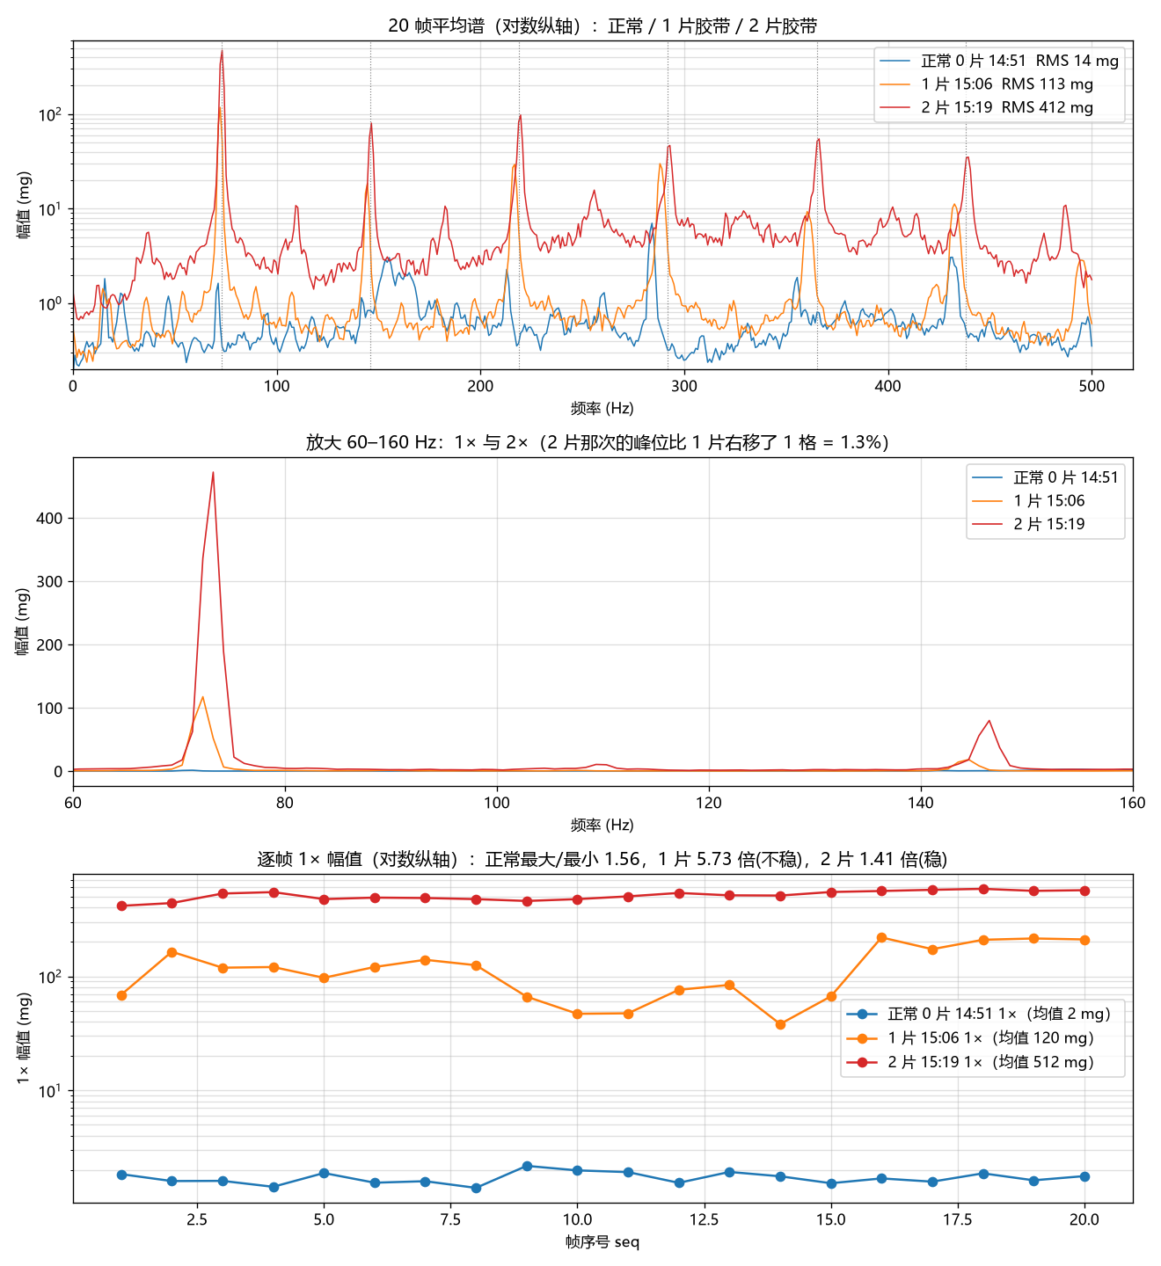
05_演示与输出/20260922_151952_tape_0_1_2_compare.png
