liyunlong-fred/motor-vibration-fault-detection/05_演示与输出/20260922_175755_fan9v_unbalance_X_f0001-0020_spectrum.png

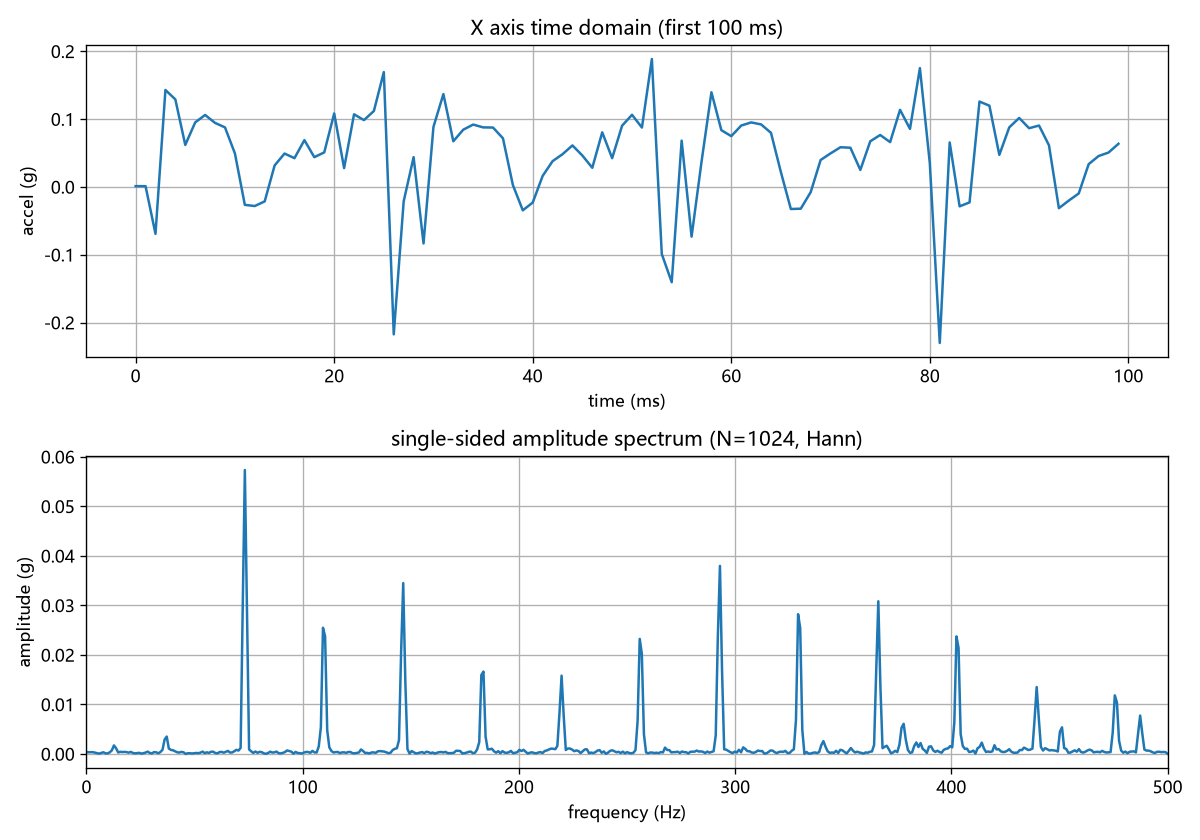
05_演示与输出/20260922_175755_fan9v_unbalance_X_f0001-0020_spectrum.png
