liyunlong-fred/motor-vibration-fault-detection/06_笔记与踩坑/开发问题/Q-02_MPU6050_Z轴异常.md

---
kb_id: PROJECT-ISSUE-Q02
kind: troubleshooting
domain: hardware
lifecycle: current
authority: supporting
last_verified: 2026-09-27
migration_source: C:/Work/备份/电机振动故障检测/_Obsidian迁移前/_20260924/电机振动故障检测_项目规划.md
issue_id: Q-02
source_paths:
  - 05_演示与输出/boardlog/20260927_002718_boardlog.txt
  - 05_演示与输出/boardlog/20260927_003113_boardlog.txt
  - 05_演示与输出/boardlog/20260927_003214_boardlog.txt
  - 05_演示与输出/boardlog/20260927_003258_boardlog.txt
  - 05_演示与输出/boardlog/20260927_003336_boardlog.txt
  - 05_演示与输出/boardlog/20260927_003446_boardlog.txt
---

# MPU6050 Z 轴异常

## 1. 当前结论

器件异常证据和 WHO_AM_I 不可作为唯一门禁的经验仍有效；当前数据契约已固定 X 测量轴、Y 重力轴，不再采用原记录中的 Y 测量轴。2026-09-27 的六面静态记录显示当前接入模块三轴均可正负响应重力，标定系数见本页⑧；该结果尚未接入运行链路，且缺少模块身份和独立复测。

## 2. 问题概述

MPU6050 平放静止时 Z 轴只有 0.13 g，翻转模块读数也不变号

> **类型**：硬件故障排查（不是报错），发生在 D2 传感器驱动联调阶段。

### 2.1 编号 / 标题

Q-02 — GY-521 模块（`WHO_AM_I` 读回 `0x60`）平放静止时 Z 轴仅 0.13 g、翻转后读数不变号，定位到 Z 轴机械故障。

### 2.2 时间 / 阶段

2026-09-15；D2（驱动联调，`iic.c` / `mpu6050.c` 已写完、串口能打印三轴 g 值）。

### 2.3 现象（实测原文）

模块平放静止，串口每 100 ms 打印 `x, y, z`（单位 g）：

```text
0.0061, 0.0527, 0.1340
0.0010, 0.0479, 0.1357
0.0022, 0.0488, 0.1309
```

X≈0、Y≈0.05、Z≈0.13 → **三轴矢量和只有 ≈0.14 g，而静止时它必须恒为 1.000 g**。
伴随现象：上下晃动时 Z 变化明显（后判定：晃动会让三轴一起动，**不能**作为"该轴正常"的证据）。

### 2.4 排查过程（按"软件 → 传输 → 器件"三步逼问）

1. **IIC 是否丢位**：向 `0x19/0x1A/0x1B/0x1C` 分别写入 `0x07/0x06/0x18/0x10` 并回读，四个值全部原样返回 → 读写 bit 级正确。
2. **Z 的字节是否真的搬回来了**：从 `0x3B` 连读 8 字节得 `00 48 02 5C 08 A0 | 10 00`，末两字节是温度（`0x1000` → 48.6 ℃，与前两次读数 51.3 ℃ / 50.7 ℃ 同量级）→ **Z 之后的字节正常，说明前 6 个字节（含 Z）传输无误**。
3. **配置是否关了轴**：读 `0x6C`(PWR_MGMT_2) = `0x00`（`STBY_ZA=0`，Z 轴没被待机）；`ACCEL_CONFIG=0x00`（±2g、不自检、无高通）→ 配置无异常。
4. **四姿势测试**（每个姿势静止读数，看三轴矢量和）：

| 姿势 | 重力应落在 | 实测代表值 | 三轴矢量和 | 判定  |
| ----- | --- | --- | --- | --- |
| 芯片面朝上 | Z ≈ +1.000 | (0.002, −0.093, 0.131) | **0.161 g** | ❌ |
| 面朝下 | Z ≈ −1.000 | (0.000, −0.031, 0.075) | **0.081 g** | ❌ |
| 立长边 | Y ≈ ±1.000 | (0.004, 0.985, 0.126)  | 0.993 g | ✅ |
| 立短边 | X ≈ ±1.000 | (−1.019, 0.001, 0.070) | 1.021 g | ✅ |

   → X、Y 轴都能读到完整 1 g；**只有重力落在 Z 方向时模长崩到 0.1 g**，且面朝上/下读数同为正值、**不变号**。
   （附注：立短边时 `X=−1.019` 要隔 5~6 行才出现一次，实为 6 cm 小板立在短边上不稳、大部分时间已倒下；倒下那些行 X≈Y≈0 而 Z 仍≈0.07 —— **再次佐证坏的是 Z**。）
5. **排除另两种解释**：①若是模块倾斜，重力必然分到某个面内轴上，而实测面内两轴都≈0；②若是量程配错，三轴应等比缩放，X/Y 就不可能准确读出 1 g。
6. **加速度自检（决定性一步）**：逐个使能 `XA_ST/YA_ST/ZA_ST`，比较读数变化：

```text
ACCEL_CONFIG=0x00 -> x=  20  y= 768  z= 2180    自检关
ACCEL_CONFIG=0x80 -> x= 724  y= 600  z= 2240    X 轴自检响应 = +704
ACCEL_CONFIG=0x40 -> x=  64  y=   8  z= 2080    Y 轴自检响应 = −760
ACCEL_CONFIG=0x20 -> x=−640  y= 880  z=24752    Z 轴自检响应 = +22572  ← 比 X/Y 大约 30 倍
```

### 2.5 根本原因

1. 自检是芯片用**静电把质量块推开**，能直接检验敏感元件是否还活着。三个轴都有响应 → **Z 轴不是"死轴"**（此结论推翻了排查中途"Z 轴敏感元件失效"的初判）。
2. 但 Z 的响应量级 **22572 LSB（≈1.38 g）**，而 X/Y 只有 704 / −760 LSB，**相差约 30 倍**；同一时刻重力（1 g）却完全推不动 Z（只读到 0.13 g）。**"重力推不动、静电一推就飞"是 MEMS 质量块粘滞／弹性梁刚度异常的典型特征**。
3. 结合 `WHO_AM_I` 读回 **`0x60`**（正品应为 `0x68`）→ 判定为**仿品/次品芯片，Z 轴机械特性失效**，与软件、接线、配置均无关。

### 2.6 解决方法

1. **两个抢救动作（均已执行、均无效，作为已知排除项记录）**：
   - ① 信号链复位：写 `0x68 = 0x07`（陀螺+加速度+温度）→ `delay_ms(100)` → 重写 `PWR_MGMT_1=0x01` 唤醒；
   - ② 给模块轻微机械振动（弹一下板子），尝试震开粘滞的质量块。
2. **处置路线（二选一，最终选择待定）**：A=换取/更换模块（`0x60` 仿品 + Z 轴失效，退换理由充分，且原计划为"1 主 1 备"）；B=**弃用 Z 轴，改用 X 或 Y 轴单轴方案**继续推进。
3. **单轴方案成立的理由**：不平衡的 1× 转速峰、轴承磨损的高频宽带能量，用**任一单轴**的加速度谱都能捕捉，本项目 3 类判别不依赖三轴；X/Y 实测精度良好（1.019 g / 0.985 g，误差 <2%），自检响应也在正常量级。
4. **安装方式相应调整**：模块改为**立式贴装**，让 X（或 Y）轴沿振动测量方向；固定方式仍沿用 相关页面 的可移动夹具，只是从"平贴"改为"立贴"。
5. **永久保留的代码改动**：`mpu6050_init()` 中**显式写 `PWR_MGMT_2 = 0x00`**（不依赖复位默认值——兼容芯片默认值不一定相同），并把 `WHO_AM_I`、量程一起打印进开机日志；`WHO_AM_I` 判据保持"只记录不判死"（仅 `0x00`/`0xFF` 视为通信失败）。

### 2.7 验证结果

- 两个抢救动作执行后，平放 Z 仍为 0.13 g → **硬件故障确认，软件层已彻底排除**；
- 判据可复现：任意一次上电后跑"四姿势 + 自检"，都会重现同样数字特征（Z 方向模长崩塌到 ≈0.1 g、Z 自检响应超常约 30 倍）；
- **待办**：换取模块或启用备件后复测，结果**沿用 Q-02 编号追加**到本条（见下方补充位），不新开编号。

### 2.8 经验与可复用点

- **口诀**："**静止看模长，姿态看哪个轴**"——单轴读数完全由摆放姿势决定，唯一恒定的是三轴矢量和 ≈ 1.000 g；某轴不响应重力时模长会立刻崩塌到 0.1 g 量级。
- **"晃动时数值会变"不能证明轴是好的**：任何方向的运动都会让三轴一起动；**只有"静止时哪个轴 ≈ ±1 g"才是有效判据**。
- **"死轴"与"坏轴"用自检区分**：自检靠静电激励、不依赖摆放姿势；响应 ≈0 = 死轴，响应量级异常（超常数十倍）= 机械特性失效。
- **做姿态测试必须先固定模块**：小板立短边极易倒下，中途倒下会制造"时好时坏"的假象、浪费大量排查时间（本次 X 轴"隔五六行才出现一次"正是此坑）。可靠做法：靠书本/盒子边、橡皮泥、台钳或双面胶固定。
- **山寨模块的 `WHO_AM_I` 不可当门禁**："只记录不判死"，真正的判据是"写进去能读回来 + 数据物理合理"。本次正是先放宽了这条判据才没卡在 `0x60` 上，从而查到真正的 Z 轴故障。
- **面试话术**："我用四姿势模长测试把故障从软件层逼到器件层——IIC 写读回四连通过、`PWR_MGMT_2` 确认没关轴、连读 8 字节里 Z 之后紧跟的温度正常（说明传输没问题）；再用加速度自检发现 Z 轴响应是 X/Y 的 30 倍而重力却推不动它，判定 MEMS 质量块异常。最后改单轴方案继续推进，没有产生停工期。"

> **Q-02 补充（换件复测 + 两颗同时读全 0 的定位，编号不变）**
> 
> **① 备件（第二颗同款模块）复测：同样是 Z 轴坏，只是数值不同**
> 
> - 平放：`x≈0.001、y≈0.005、z≈0.444` → 三轴矢量和 ≈ **0.44 g**
> - 立边（Y 轴朝下）：`x≈0.001、y≈1.003、z≈0.441` → 三轴矢量和 ≈ 1.09 g
> - 三轴自检响应：X **+8376**、Y **−88**、Z **+18608**
> - **反解**：姿势 A（重力全压在 Z 上）`S_z×1 + O_z = 0.4438`；姿势 B（Z 水平、无重力分量）`S_z×0 + O_z = 0.441` → **O_z ≈ 0.44 g，S_z ≈ 0.003 ≈ 0**
> - 第一颗用同样方法反解（0.133 / 0.127）→ **O_z ≈ 0.13 g，S_z ≈ 0**
> - **结论：两颗模块是同一个病——"Z 轴灵敏度为 0 + 一个固定零偏"，只是零偏不同（0.13 g / 0.44 g）**。这就不是偶发的个体故障，而是**同一批仿品的系统性缺陷**（疑似晶圆测试不合格后重新打标出售）。两颗的 X、Y 轴均正常。
> 
> **② 方法升级：用"两个姿势"反解灵敏度与零偏**（比只看模长更有力）
> 姿势 1 让重力压在该轴上、姿势 2 让该轴水平，则 **灵敏度 S =（读数1 − 读数2）÷ 1 g**、**零偏 O = 读数2**。这样能把"灵敏度为 0"与"零偏过大"两种故障分开——只看三轴矢量和时，两者表现完全相同（都是模长不足 1 g）。
> 
> **③ 两颗同时读全 0 的定位：I2C 总线扫描**（本次最有复用价值的一招）
> 
> - 触发：两颗模块读数全为 `0x00`，**且其中一颗从未接过 5 V** → 说明变化在主机侧（接线/供电/代码），不是 5 V 损坏
> - 前置纪律：**读函数的返回值必须检查**。否则"读失败"时缓冲区根本没被写入，打印出来的全 0 是假数据，会把人直接引向"模块坏了"的错误结论
> - 做法：7 位地址 `0x08~0x77` 逐个做 `iic_start() → iic_send_byte(addr<<1) → iic_wait_ack()`，有应答就打印地址
> - 实测结果：**`0x1A`、`0x50`、`0x68`** 三个地址有应答（`0x1A` 应为同总线上板载的音频/磁力计等器件，引脚表注明 PB8/PB9 上还挂 ST480MC/ES8388）
> - 判读：`0x50` = 板载 24C02 EEPROM，是**常驻路标**——它应答就证明 PB8/PB9、上拉电阻、总线全都正常；`0x68` = MPU6050 有应答 → **模块是活的**
> - 结论：总线正常 + 器件在线，"全 0"出在主机侧（读失败被当成 0 打印），并非模块损坏
> - 口诀：**扫到 0x50 说明总线活，扫到 0x68 说明模块活**
> 
> **④ 5 V 供电的教训（定为纪律）**
> 把 VCC 从 3.3 V 改接 5 V 后，该模块全部寄存器读回 `0x00`（从机不应答）。虽然事后查明另一颗从未接 5 V 也出现全 0、说明当时另有接线或读码问题，但风险结论仍然成立。**纪律：仿品 GY-521 未必按原理图做 LDO/电平转换，5 V 有烧毁芯片的风险——这类模块一律只用 3.3 V，不要再试 5 V。**
> 
> **⑤ 处置与等货期安排**
> 
> - 已下单 **2 颗原装进口 MPU6050，预计 3 天到货**；到货后按本节继续复测，**编号仍沿用 Q-02**。
> - **等货期不停工**：用**合成信号桩函数**替代 `mpu6050_read_accel()`（生成已知频率的 45 Hz 基频 + 90 Hz 二次谐波），先把「1 kHz 采样 → 攒窗 → 加窗 → FFT → 找谱峰」整条链路跑通。用已知频率还能顺带校验频率刻度、频率分辨率与加窗效果——这是真传感器做不到的（真实转速未知）。原装到货后只需换掉一行调用。
> 
> **⑥ 仍待补充（原装模块到货后填）**
> 
> - 原装模块的 `WHO_AM_I`、四姿势三轴矢量和表、三轴自检响应值；
> - 最终选定的测量轴（X 或 Y）与安装方式（立贴角度 / 夹具形式）；
> - 是否把"测量轴"写进数据集 `meta.csv`。

> **⑦ 补充（2026-09-16）：测量轴已选定 = Y 轴（编号仍为 Q-02）**
> 
> - **用户确认**：按现有的传感器连接/安装方式，静止时**重力加速度压在 Y 轴**（y ≈ ±0.99~1.0 g、x ≈ 0、z ≈ 0），属**设计选择而非笔误**；测试阶段即按此预设，故桩信号参数命名为 `APP_FAKE_Y_G`（不是 `APP_FAKE_Z_G`）。
> - **影响面（固化为代码约定）**：桩信号与后续真实采样、特征提取、数据集 `meta.csv` 的测量轴字段、屏上显示，**一律以 Y 轴为准**，不使用 Z 轴默认值。对应实现：`app_config.h` 的 `APP_FAKE_Y_G` + `app_sample.c` 中 `accel->y = APP_FAKE_Y_G; accel->z = 0.0f;`。
> - **⑥ 待办变更**：「最终选定的测量轴（X 或 Y）与安装方式」一项**就此关闭**；「是否把测量轴写进 `meta.csv`」仍待定（相关页面 落地时再定）。
> - **提醒**：本约定与"哪颗模块的哪个轴坏"无关——即便原装模块到货、三轴全部正常，仍按 Y 轴承载重力/振动，以免固件、数据集、模型三处口径打架。

> **⑧ 补充（2026-09-27）：当前接入模块六面静态标定**
>
> 本次使用 `APP_CALIBRATION_MEAN_LOG` 输出的 `CAL_MEAN`，每个姿态连续记录 3 个 1024 点窗口（1 kHz）。六份日志未记录实际摆放顺序，故下表的 `X+ / X-` 等名称按**传感器输出的正/负 1 g 响应**归类，不推断 PCB 实体哪一面朝上。每格是 3 个窗口均值的均值，单位为原始 count。
>
> | 推定姿态 | boardlog | X | Y | Z |
> | --- | --- | ---: | ---: | ---: |
> | X- | `20260927_002718_boardlog.txt` | -15680.33 | 54.33 | 210.67 |
> | Y+ | `20260927_003113_boardlog.txt` | 703.00 | 16473.67 | 187.33 |
> | Y- | `20260927_003214_boardlog.txt` | 916.33 | -16396.33 | 110.33 |
> | Z+ | `20260927_003258_boardlog.txt` | 542.33 | 12.67 | 17064.67 |
> | Z- | `20260927_003336_boardlog.txt` | 1104.00 | -2.67 | -16623.67 |
> | X+ | `20260927_003446_boardlog.txt` | 17286.00 | 172.00 | 375.33 |
>
> 同一姿态内，任一轴的 3 个窗口峰峰值最大为 14 count（Y- 的 X 值），静态读数稳定。对每轴正负面使用 `bias=(p+n)/2`、`scale=(p-n)/2` 得到：
>
> | 轴 | bias（count） | scale（count/g） | 相对 ±2 g 名义 16384 count/g |
> | --- | ---: | ---: | ---: |
> | X | 802.83 | 16483.17 | +0.61% |
> | Y | 38.67 | 16435.00 | +0.31% |
> | Z | 220.50 | 16844.17 | +2.81% |
>
> 因而此次标定的三轴换算式为：
>
> ```text
> ax_g = (raw_x - 802.83) / 16483.17
> ay_g = (raw_y -  38.67) / 16435.00
> az_g = (raw_z - 220.50) / 16844.17
> ```
>
> 将同一批六面数据回代后，目标轴为 ±1 g，最大非目标轴残差为 0.01827 g（Z- 姿态的 X 轴），六组矢量模长为 1.00000～1.00017 g。该回代仅证明本批数据的仿射标定自洽，不能替代独立精度、温漂或交叉轴灵敏度验证。
>
> **结论与边界：** 当前接入模块的 X/Y/Z 均能稳定地在正、负重力方向响应，Z 轴不再呈现本问题历史记录中的“灵敏度近零且不变号”特征；但日志未含模块身份或 `WHO_AM_I`，不能据此断言它就是历史哪一颗或已更换的原装件。上述系数尚未写入采样、FFT 或 Python 换算链路；当前正式测量仍使用未校准的 X 轴原始数据。后续若要应用补偿，应先固定模块编号、安装姿态并以独立复测确认。
