liyunlong-fred/motor-vibration-fault-detection/06_笔记与踩坑/开发问题/README.md

---
kb_id: PROJECT-ISSUES-GUIDE
kind: troubleshooting
domain: project
lifecycle: current
authority: supporting
last_verified: 2026-09-24
migration_source: C:/Work/备份/电机振动故障检测/_Obsidian迁移前/_20260924/电机振动故障检测_项目规划.md
---

# 开发问题与解决记录

## 1. 维护规则

每个问题在独立 Q 文件持续补充，不再回填历史总稿。记录必须包含日期、环境、复现、证据和结论；新问题从 Q-06 递增。Q-01 的轴承磨损仅是历史背景，当前分类范围以 Q-05 为准。

## 2. 记录说明

> **用途**：沉淀真实问题及其解决过程，作为调试手册、面试复盘素材和项目证据。
> **与风险文档的分工**：[风险、扩展与参考资料](../../01_文档/项目规划/09_风险扩展与参考资料.md)记录事前预防；本目录记录已经发生的问题、排查过程、根因和验证结果。
> **与其他记录的分工**：本节只放**整理后的结论**（文字可检索、可引用、可写进文档）；原始截图、示波器图和临时调试代码放项目目录 `06_笔记与踩坑/`，板端串口日志放 `05_演示与输出/boardlog/`；两边用**问题编号**（Q-01、Q-02…）互相引用。

### 2.1 登记规则

1. 你提出开发中遇到的具体问题（现象/报错/截图） → 助手解答，可能来回多轮；
2. 你说"**记录这个问题和回答**" → 助手把**同一个问题的多轮对话合并整理成一条**：去掉来回试探与重复内容，保留结论、关键命令/代码、报错原文；
3. 在“问题索引”追加一行，并新建或更新对应的 Q-xx 独立文档；
4. 更新该问题的当前结论、验证证据和可复用经验；不维护历史总稿的修订记录；
5. **编号只增不改**：后续补充同一问题用"Q-01（补充）"或直接改写该条正文，**不新开编号**，这样你在笔记/简历里可以稳定引用。

### 2.2 记录模板

| # | 字段 | 写什么 |
| --- | --- | --- |
| 1 | 编号 / 标题 | 形如 `Q-01 Keil 下载报 L6047U`——"编号 + 一句话现象" |
| 2 | 时间 / 阶段 | 日期 + 对应里程碑（D0…D14），方便回溯当时做到哪一步 |
| 3 | 现象 | **报错原文**或实测现象，关键行照抄不要转述（以后才能搜到） |
| 4 | 排查过程 | 做了哪些验证、排除了哪些可能——**这段最有面试价值**，体现的是定位思路而不是"背答案" |
| 5 | 根本原因 | 一句话讲清"为什么会这样"（机制层面，不是"重新装一遍就好了"） |
| 6 | 解决方法 | 可复现的具体步骤（菜单路径 / 命令 / 代码片段 / 接线改动） |
| 7 | 验证结果 | 改完怎么确认真的好了（现象消失、指标数字、连续运行多久没复发、留了哪张图） |
| 8 | 经验与可复用点 | 同类问题的快速判断口诀；能不能写进简历、面试被问到时怎么讲 |

### 2.3 问题索引

| 编号 | 日期 | 阶段 | 一句话问题 | 关键词 | 结论（一句话） |
| ---- | --- | --- | --- | --- | --- |
| Q-01 | 2026-09-11 | D0（设计期） | 加速度谱 vs 二次积分位移谱，哪个更能区分正常/不平衡/轴承磨损 | 频率加权、积分漂移、轴承宽带能量 | 用**加速度谱**；二次积分压制高频证据、放大低频漂移，对本项目 3 类问题弊大于利 |
| Q-02 | 2026-09-15 | D2（驱动联调） | MPU6050 平放静止时 Z 轴只有 0.13 g，翻转模块读数也不变号 | WHO_AM_I=0x60、四姿势模长、加速度自检、山寨模块 | **Z 轴机械特性失效（重力推不动、自检响应却是 X/Y 的 30 倍）→ 判为坏件；X/Y 轴正常，改单轴方案即可继续** |
| Q-03 | 2026-09-21 | D2（采集链路验证） | 串口助手能收到数据、Hex 也能看到帧头，关掉助手后 `recv.py` 一个字节都收不到 | DTR/RTS、一键下载电路、NRST、CH340、pyserial | **pyserial 打开串口时不驱动 DTR/RTS、沿用驱动里已有的线状态；线停在 DTR=0 / RTS=1 会把 MCU 按在复位上 → 在 `recv.py` 里显式置 `ser.dtr=False` 与 `ser.rts=False` 即恢复** |
| Q-04 | 2026-09-21 | D2（采集链路验证） | 真实传感器三轴读数间歇性"整值错乱"：Z 读到 X 的值、平放时读不到重力、连读三次差很多 | 共用 I2C 总线、板载 24C02、PB8/PB9、软件 IIC 误码、三轴模长自检 | **PB8/PB9 是板载 24C02 的总线，MPU6050 与其共用走线与上拉，软件 IIC 在该负载下间歇性采错位；改用专属引脚 PB6/PB7 后立即恢复（PWR=0x01、ID=0x68 恒定，三连读差值降到噪声级）** |
| Q-05 | 2026-09-24 | D5（采数方案修订） | 第三类故障是否继续采用轴承磨损，有限条件下能否真实模拟 | 标签可信度、可控注入、重复性、夹具边界 | **改为安装固定处机械松动；用指定紧固点回退圈数或定厚间隙受控注入，轴承异常不作为主类或扩展类保留** |

### 2.4 详情入口

- [Q-01：加速度谱与位移谱](Q-01_加速度谱与位移谱.md)
- [Q-02：MPU6050 Z 轴异常](Q-02_MPU6050_Z轴异常.md)
- [Q-03：串口助手正常但 recv.py 无数据](Q-03_recv_py无数据.md)
- [Q-04：IIC 三轴整值错乱](Q-04_IIC三轴整值错乱.md)
- [Q-05：第三类故障改为机械松动](Q-05_第三类故障改为机械松动.md)
