liyunlong-fred/motor-vibration-fault-detection/知识库/模板/故障排查.md

---
kb_id: ""
kind: troubleshooting
domain: project
lifecycle: draft
authority: supporting
last_verified: "{{date:YYYY-MM-DD}}"
---

# {{title}}

## 现象

## 环境与复现条件

## 排查过程

## 根因

## 修复

## 验证证据

## 可复用经验
