liyunlong-fred/motor-vibration-fault-detection/04_数据集/debug_raw/20260926T193800_0800_fanA_r001_fanA_unknown_9V_X_r0001-0600.csv

# meta_json={"schema_version":3,"record_id":"20260926T193800_0800_fanA_r001","data_role":"debug","source_type":"real","device_id":"fanA","device_type":"fan","session_id":"continuous_fifo_test","acquired_at":"2026-09-26T19:38:00+08:00","observed_condition":"unknown","target_label":"unassigned","label_basis":"unknown","label_confidence":"unknown","fault_level":0,"tape_count":0,"measurement_axis":"X","gravity_axis":"Y","voltage_set_v":9.0,"quality_status":"pending","notes":"FIFO连续采样、三槽窗口、UART DMA验收","fs_hz":1000,"frame_n":1024,"afs_code":0,"frames":600,"first_seq":1,"last_seq":600,"lost_frames":0,"sample_id_gaps":0,"capture_mode":"fifo_continuous","window_span_ms":614400.0,"actual_fs_hz":1000.0}
764
756
768
736
772
696
628
720
700
672
648
632
716
664
712
696
652
628
732
640
704
704
748
676
684
660
636
628
680
676
808
752
712
660
716
664
780
728
760
724
720
752
736
692
760
704
652
720
712
760
712
724
780
748
664
672
704
680
608
728
720
696
712
708
700
704
760
652
728
764
744
672
692
724
784
752
748
744
704
740
736
696
744
628
652
628
660
700
656
684
684
640
640
660
748
728
608
704
660
700
648
660
684
720
696
616
624
664
724
748
768
740
728
724
704
744
720
720
736
748
708
684
792
660
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
