liyunlong-fred/motor-vibration-fault-detection/03_Python工具/test_harmonics.py

# 03_Python工具\test_harmonics.py
"""
功能: harmonics.py 的自检脚本 —— 用"已知基频的合成信号"验证工具找基频找得准不准
用法: python test_harmonics.py
说明: 不依赖 pytest, 只用 numpy。全部通过则退出码 0, 有任何一条失败则退出码 1。
      为什么要先写这个: 真实风扇的真实转速我们并不知道, 所以没法判断工具算得对不对;
      合成信号的基频是我们自己定的, 工具必须把这个已知答案找回来, 才说明算法可信。
"""
import os
import shutil
import sys

import numpy as np

sys.path.insert(0, os.path.dirname(os.path.abspath(__file__)))   # 让本脚本能 import 同目录的 harmonics.py
import harmonics
sys.path.insert(0, os.path.join(os.path.dirname(os.path.abspath(__file__)), "py_common"))
import metadata

FS = 1000          # 采样率 Hz, 与固件一致
N = 1024           # 每帧点数, 与固件一致
FRAMES = 20        # 帧数

_results = []      # [(用例名, 是否通过, 补充信息), ...]


def check(name, ok, detail=""):
    """记录一条自检结果并立刻打印"""
    _results.append((name, bool(ok), detail))
    print(("  [PASS] " if ok else "  [FAIL] ") + name + (("    " + detail) if detail else ""))


def make_counts(f0, amps, noise=0.004, frames=FRAMES, n=N, fs=FS, seed=1):
    """造一段"已知基频"的加速度信号, 并换成固件那种 int16 原始计数
    f0   : 基频 Hz
    amps : {倍频 k: 幅值(g)}, 例如 {1: 0.5, 2: 0.1} 表示 1× 是 0.5g、2× 是 0.1g
    noise: 噪声标准差(g)
    返回 : int16 计数数组(长度 frames*n), 可直接喂给 harmonics.average_spectrum()
    """
    rng = np.random.default_rng(seed)
    out = []
    for _ in range(frames):
        t = np.arange(n) / fs
        x = np.zeros(n)
        for k, a in amps.items():
            # 每帧给一个随机相位: 模拟"每次采集相位对不上", 检验平均谱不会把峰平均掉
            x += a * np.sin(2.0 * np.pi * k * f0 * t + rng.uniform(0.0, 2.0 * np.pi))
        x += rng.normal(0.0, noise, n)
        out.append(x)
    sig = np.concatenate(out)
    return np.clip(np.round(sig * 16384.0), -32768, 32767).astype(np.int16)   # afs_code=0 → 16384 格/g


def analyze_counts(counts, **kw):
    """计数 → 平均谱 → 谐波族分析, 走的是和 harmonics.py 主流程完全相同的代码路径"""
    f, amp, nf = harmonics.average_spectrum(counts, FS, N)
    return harmonics.analyze(f, amp, **kw), f, amp


# ---------------------------------------------------------------- 用例

def case_1_two_harmonics():
    """T1: 45 Hz 基频 + 90 Hz 二次谐波(幅值 5:1) —— 规划文档里合成桩函数的那组数"""
    print("T1  45Hz 基频 + 90Hz 二次谐波 (幅值比 5:1)")
    counts = make_counts(45.0, {1: 0.50, 2: 0.10})
    r, _, _ = analyze_counts(counts, f0_min=40.0)

    check("T1.1 基频 ≈ 45 Hz", r["f0"] is not None and abs(r["f0"] - 45.0) <= 1.0,
          "实测 f0 = %.2f Hz" % (r["f0"] if r["f0"] else -1.0))
    check("T1.2 最强倍频是 1×", r["strongest"] is not None and r["strongest"]["k"] == 1,
          "最强 = %s" % (r["strongest"]["k"] if r["strongest"] else None))
    check("T1.3 第二强倍频是 2×", r["second"] is not None and r["second"]["k"] == 2,
          "第二强 = %s" % (r["second"]["k"] if r["second"] else None))
    check("T1.4 转速 ≈ 2700 rpm", abs(r["rpm"] - 45.0 * 60.0) <= 60.0, "实测 %.0f rpm" % r["rpm"])
    check("T1.5 信号可信", r["reliable"] is True, "峰本底比 %.1f" % r["snr"])


def case_2_fan_like_1x_and_4x():
    """T2: 模仿实测那台风扇 —— 1× 最强、4× 第二强, 2×/3× 很弱"""
    print("T2  78.8Hz 基频: 1×(1.00) 2×(0.12) 3×(0.06) 4×(0.83)")
    counts = make_counts(78.8, {1: 1.00, 2: 0.12, 3: 0.06, 4: 0.83})
    r, _, _ = analyze_counts(counts)

    check("T2.1 基频 ≈ 78.8 Hz", r["f0"] is not None and abs(r["f0"] - 78.8) <= 1.5,
          "实测 f0 = %.2f Hz" % (r["f0"] if r["f0"] else -1.0))
    check("T2.2 最强倍频是 1×", r["strongest"] is not None and r["strongest"]["k"] == 1,
          "最强 = %s×" % (r["strongest"]["k"] if r["strongest"] else None))
    check("T2.3 第二强倍频是 4×", r["second"] is not None and r["second"]["k"] == 4,
          "第二强 = %s×" % (r["second"]["k"] if r["second"] else None))
    check("T2.4 转速 ≈ 4728 rpm", abs(r["rpm"] - 78.8 * 60.0) <= 90.0, "实测 %.0f rpm" % r["rpm"])


def case_3_low_subharmonic_not_selected():
    """T3: 旧工具会把 39.4 Hz 子谐波反推成基频；新规则只承认已验证的 1×范围。"""
    print("T3  39.4Hz 子谐波 + 78.8Hz 主峰 —— 默认必须选 78.8Hz")
    counts = make_counts(39.4, {2: 1.00, 4: 0.12, 6: 0.06, 8: 0.83})
    r, f, amp = analyze_counts(counts)

    check("T3.1 默认基频 ≈ 78.8 Hz", r["f0"] is not None and abs(r["f0"] - 78.8) <= 1.5,
          "f0 = %.2f Hz" % (r["f0"] if r["f0"] else -1.0))
    check("T3.2 39.4 Hz 不会成为默认机械 1×", r["f0"] is not None and r["f0"] >= harmonics.DEFAULT_F0_MIN,
          "f0 = %.2f Hz" % (r["f0"] if r["f0"] else -1.0))

    meta = {"axis": "Z", "fs": str(FS), "per_frame": str(N), "afs_code": "0"}
    text = harmonics.format_report("syn_39.4.csv", meta, f, amp, FRAMES, r)
    check("T3.3 报告明确排除低频子谐波", "36.6 Hz 一类低频峰不再参与默认基频候选" in text,
          "报告含新判据")


def case_4_pure_noise():
    """T4: 只有噪声没有振动 —— 工具必须说"不可信", 不能硬编一个转速出来"""
    print("T4  纯噪声(无任何谐波)")
    counts = make_counts(0.0, {}, noise=0.02)
    r, _, _ = analyze_counts(counts)

    check("T4.1 标记为不可信", r["reliable"] is False, "峰本底比 %.1f" % r["snr"])


def case_5_csv_roundtrip():
    """T5: 走完整文件链路 —— 按 recv.py 的格式写 csv, 再让工具读回来分析
    临时文件就写在本脚本旁边的小目录里, 测完删掉(不污染 04_数据集)"""
    print("T5  按 recv.py 格式落盘的 csv 能正确读回")
    tmp = os.path.join(os.path.dirname(os.path.abspath(__file__)), "_selftest_tmp")
    if not os.path.isdir(tmp):
        os.makedirs(tmp)
    try:
        path = os.path.join(tmp, "20260921_120000_fanA_baseline_9V_X.csv")
        counts = make_counts(45.0, {1: 0.50, 2: 0.10})
        with open(path, "w", encoding="utf-8") as fp:
            metadata.write_header(fp, {
                "schema_version": 2, "record_id": "syn45", "data_role": "debug",
                "source_type": "synthetic", "device_id": "fanA", "session_id": "test",
                "observed_condition": "baseline", "target_label": "normal",
                "label_basis": "controlled_injection", "label_confidence": "confirmed",
                "measurement_axis": "X", "gravity_axis": "Y", "voltage_set_v": 9,
                "fs_hz": FS, "frame_n": N, "afs_code": 0, "frames": FRAMES,
                "first_seq": 1, "last_seq": FRAMES, "quality_status": "pass",
            })
            fp.write("\n".join(str(int(v)) for v in counts))

        meta, samples = harmonics.load_csv(path)
        check("T5.1 读到元数据 fs_hz/frame_n", int(meta.get("fs_hz")) == FS and int(meta.get("frame_n")) == N,
              "meta = %s" % meta)
        check("T5.2 读到的样本数与写出的一致", samples.size == counts.size,
              "%d vs %d" % (samples.size, counts.size))

        f, amp, nf = harmonics.average_spectrum(samples, int(meta["fs_hz"]), int(meta["frame_n"]),
                                                int(meta["afs_code"]))
        check("T5.3 平均了 20 帧", nf == FRAMES, "nf = %d" % nf)
        r = harmonics.analyze(f, amp, f0_min=40.0)
        check("T5.4 基频 ≈ 45 Hz", r["f0"] is not None and abs(r["f0"] - 45.0) <= 1.0,
              "f0 = %.2f Hz" % (r["f0"] if r["f0"] else -1.0))
    finally:
        shutil.rmtree(tmp, ignore_errors=True)      # 自检不留垃圾


def case_6_tach_locks_mechanical_1x():
    """T6: 73.2 Hz 是机械 1×，36.6 Hz 是低频分量；TACH 必须锁定正确转速。"""
    print("T6  TACH 4360 rpm → 72.663 Hz，频谱峰 73.2 Hz；36.6 Hz 不得成为基频")
    counts = make_counts(36.62, {1: 0.04, 2: 0.40, 3: 0.03, 4: 0.15, 5: 0.02, 6: 0.08})
    r, _, _ = analyze_counts(counts, rpm_measured=4359.8)
    check("T6.1 TACH 锁定机械 1× ≈ 72.663 Hz",
          r["f0"] is not None and abs(r["f0"] - 72.663) <= 0.01,
          "f0 = %.3f Hz" % (r["f0"] if r["f0"] else -1.0))
    check("T6.2 TACH 锁定转速 ≈ 4360 rpm",
          r["rpm"] is not None and abs(r["rpm"] - 4359.8) <= 0.1,
          "rpm = %.1f" % (r["rpm"] if r["rpm"] else -1.0))
    check("T6.3 谱峰与 TACH 1× 对齐", r["one_x_detected"] is True and
          r["f0_peak"] is not None and abs(r["f0_peak"] - 73.24) <= 1.5,
          "peak = %.2f Hz" % (r["f0_peak"] if r["f0_peak"] else -1.0))
    r_6, _, _ = analyze_counts(make_counts(51.02, {1: 0.5, 2: 0.1}))
    r_12, _, _ = analyze_counts(make_counts(91.74, {1: 0.5, 2: 0.1}))
    check("T6.4 默认范围覆盖 6V 实测 1× ≈ 51.02 Hz",
          r_6["f0"] is not None and abs(r_6["f0"] - 51.02) <= 1.5,
          "f0 = %.2f Hz" % (r_6["f0"] if r_6["f0"] else -1.0))
    check("T6.5 默认范围覆盖 12V 实测 1× ≈ 91.74 Hz",
          r_12["f0"] is not None and abs(r_12["f0"] - 91.74) <= 1.5,
          "f0 = %.2f Hz" % (r_12["f0"] if r_12["f0"] else -1.0))


def case_7_rpm_parsing():
    """T7: 实测 RPM 只接受正数，避免空值/错误值悄悄污染基频。"""
    print("T7  实测 RPM 解析")
    check("T7.1 空 RPM 保持为空", harmonics.parse_rpm("") is None, "")
    check("T7.2 数字 RPM 能解析", harmonics.parse_rpm("3061") == 3061.0, "")
    try:
        harmonics.parse_rpm(0)
        invalid_rejected = False
    except ValueError:
        invalid_rejected = True
    check("T7.3 0 rpm 会被拒绝", invalid_rejected, "")


def main():
    print("harmonics.py 自检 (合成信号, 已知基频)")
    print("-" * 64)
    case_1_two_harmonics()
    case_2_fan_like_1x_and_4x()
    case_3_low_subharmonic_not_selected()
    case_4_pure_noise()
    case_5_csv_roundtrip()
    case_6_tach_locks_mechanical_1x()
    case_7_rpm_parsing()
    print("-" * 64)

    bad = [x for x in _results if not x[1]]
    print("共 %d 项检查, 通过 %d 项, 失败 %d 项" % (len(_results), len(_results) - len(bad), len(bad)))
    for name, _, detail in bad:
        print("  失败: %s   %s" % (name, detail))
    return 1 if bad else 0


if __name__ == "__main__":
    sys.exit(main())
