liyunlong-fred/motor-vibration-fault-detection/(commit log)

2026-09-19 chore: 初始化仓库，纳入 Keil 固件工程与 Python 工具
    [MPU6050寄存器选用表_电机振动检测.xlsx]
2026-09-20 跑通了从传感器到PC端的数据链路
    成功实现将MPU6050传感器测量的数据上传至PC端，并使用Python工具对其进行FFT的频谱分析。
    添加了测试信号（两组）与真实测量值（一组）的分析结果，放在了演示与输出文件夹中
2026-09-21 完成真实加速度的测量与频谱分析
    对风扇开启后的真实加速度进行了测量并传输到了PC端，对其进行频谱分析。
    修复了IIC的时钟线和数据线挂载在PB8/9上的传输错误，该将其挂载在了PB6/7，成功读出了正确的数值。
    还添加了对频谱的谐波族分析工具——harmonics.py，可以分析频谱的基频和倍频。
    [check_raw.py, dsp_fft.c, dsp_fft.h, harmonics.py, main.c, plot_check.py, recv.py, test_harmonics.py]
2026-09-22 推进到了可板极FFT
    已将板极FFT与PC端FFT对比，验证了板极FFT的结果正确。
    添加了帧类型——日志帧，可传输板极FFT结果信息
    在STM32工程中添加了针对板极FFT结果信息的debug路径——app_debug.c/h
    添加了py工具中的峰分析工具——peak_check.py
2026-09-24 更新了文档存档规则，正在为采集数据做准备
    将原先的各文档内容按照分类整理到了各个文件夹下，大部分规划文档存放在了01_文档文件夹下，数据采集相关的文档放在了04_数据集文件夹下。每个文档添加了多种属性以便查找，索引文件存放在了知识库文件夹下，使用obsidian 即可实各文档间的跳转。
    [manifest.csv]
2026-09-26 更新了说明文档
2026-09-26 更新了传输至PC的链路
    将原来的阻塞串口传输，转为串口TX DMA
    采样由双缓冲升级为三窗口的环形队列
    在MPU6050的BSP驱动中加入了FIFO作为加速度数据的缓冲
    [20260926T193800_0800_fanA_r001_fanA_unknown_9V_X_r0001-0600.csv]
2026-09-26 添加六面校准均值记录并记录结果
2026-09-28 采集前的准备工作（尚未将PC端采集链路一体化）
    [manifest.csv]
2026-09-28 1、增加py工具——capture_and_analyze.py，将采集和分析集中到一起。 2、修复了MPU6050初始化失败的bug 3、进行了第一轮正式数据采集
    [20260928T180118_0800_fanA_r001_fanA_baseline_6V_X_r0001-0020.csv, 20260928T181019_0800_fanA_r001_fanA_baseline_9V_X_r0001-0020.csv, 20260928T181136_0800_fanA_r001_fanA_baseline_12V_X_r0001-0020.csv, 20260928T181513_0800_fanA_r002_fanA_added_mass_12V_X_r0001-0020.csv, 20260928T181826_0800_fanA_r001_fanA_added_mass_9V_X_r0001-0020.csv, 20260928T182056_0800_fanA_r001_fanA_added_mass_6V_X_r0001-0020.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]
